lamloei/LamLoei_Board/20191214/lamloei_unofox_sfm10r4/centroid/pickplace.jpg

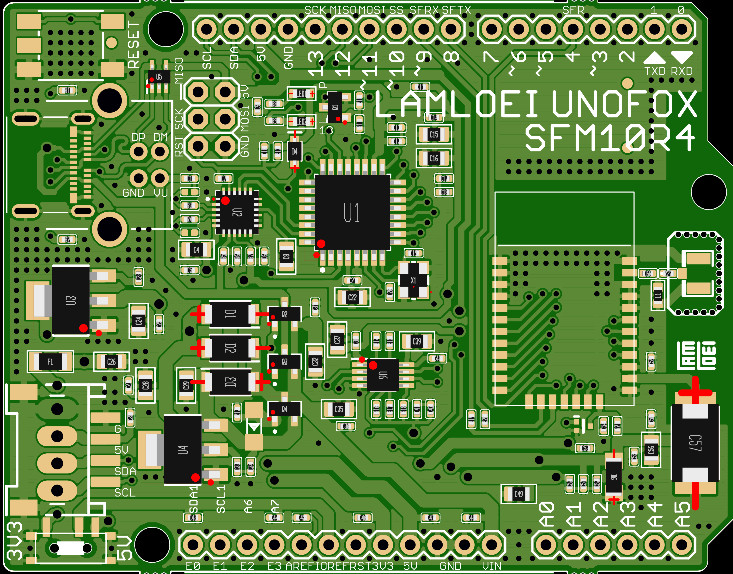
20191214/lamloei_unofox_sfm10r4/centroid/pickplace.jpg
