lamloei/LamLoei_Board/20191214/lamloei_unofox_sfm10r4/pdf/lamloei_unofox_sfm10r4.mnt.pdf

1 | ANT1 64.33 27.94 180 U.FL
2 | C1 17.46 36.83 270 100nf C0402
3 | C2 17.46 35.56 270 NC C0402
4 | C3 17.46 31.75 270 NC C0402
5 | C4 18.10 30.16 90 4.7uf C0805
6 | C5 17.46 28.26 90 100nf C0402
7 | C6 24.45 29.53 0 100nf C0402
8 | C7 20.64 36.83 90 100nf C0402
9 | C8 26.51 29.53 180 4.7uf C0805
10 | C9 23.81 43.50 180 100nf C0402
11 | C10 24.45 39.37 0 100nf C0402
12 | C11 39.05 45.40 90 100nf C0402
13 | C12 36.83 41.59 270 100nf C0402
14 | C13 36.83 40.32 270 100nf C0402
15 | C14 40.32 42.55 90 100nf C0402
16 | C15 40.32 40.96 90 4.7uf C0805
17 | C16 40.32 38.73 90 4.7uf C0805
18 | C17 41.27 36.83 90 100nf C0402
19 | C18 41.27 35.56 90 100nf C0402
20 | C19 38.42 29.85 270 10pf C0402
21 | C20 36.20 26.19 180 10pf C0402
22 | C21 32.70 27.30 270 100nf C0402
23 | C22 32.70 25.72 270 4.7uf C0805
24 | C23 12.70 27.62 0 100nf C0402
25 | C24 12.70 23.50 180 4.7uf C0805
26 | C25 14.61 23.18 180 100nf C0402
27 | C26 10.16 19.69 270 4.7uf C0805
28 | C27 11.75 17.46 0 100nf C0402
29 | C28 13.34 17.46 0 4.7uf C0805
30 | C29 17.14 17.46 180 4.7uf C0805
31 | C30 11.91 14.45 0 100nf C0402
32 | C31 29.21 24.77 0 100nf C0402
33 | C32 29.21 19.69 180 4.7uf C0805
34 | C33 21.91 9.84 180 100nf C0402
35 | C34 23.18 9.84 180 100nf C0402
36 | C35 31.43 15.24 270 4.7uf C0805
37 | C36 32.07 13.65 270 100nf C0402
38 | C37 31.27 21.75 0 4.7uf C0805
39 | C38 33.02 21.59 0 100nf C0402
40 | C39 38.73 21.59 270 4.7uf C0805
41 | C40 40.64 20.00 270 100nf C0402
42 | C41 38.73 15.24 0 100nf C0402
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
112 | ZFC2 58.42 45.72 0 FIDUCIAL1X2 FIDUCIAL-1X2
113 | ZFC3 58.42 39.69 0 FIDUCIAL1X2 FIDUCIAL-1X2
114 | ZFD1 69.85 68.58 0 FIDUCIAL1X2 FIDUCIAL-1X2
115 | ZFD2 -1.27 -15.24 0 FIDUCIAL1X2 FIDUCIAL-1X2
116 | ZFD3 69.85 -15.24 0 FIDUCIAL1X2 FIDUCIAL-1X2
117
