lamloei/LamLoei_Board/20191212/lamloei_umo32c_r2_1/pcb/3c29d403bb60a0421abf6645f51ca68c.png

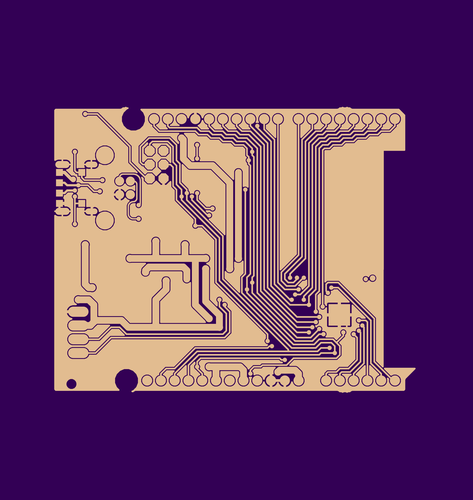
20191212/lamloei_umo32c_r2_1/pcb/3c29d403bb60a0421abf6645f51ca68c.png
