lamloei/LamLoei_Board/20191212/lamloei_umo32c_r2_1/pcb/5b07fe66cb3bcef6738aa973fb65b398.png

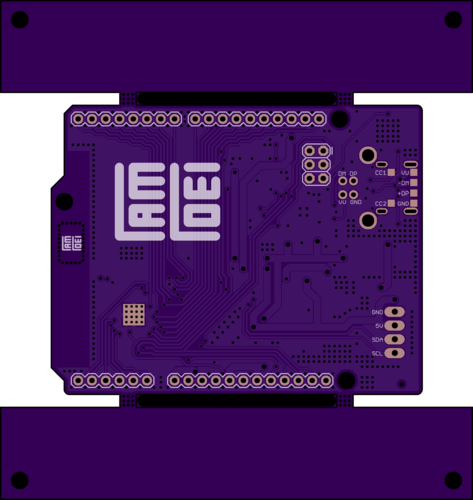
20191212/lamloei_umo32c_r2_1/pcb/5b07fe66cb3bcef6738aa973fb65b398.png
