lamloei/LamLoei_Board/20191212/lamloei_umo32c_r2_1/pcb/7d4cf361d7756bc5d7ffdf4a4ff68cea.png

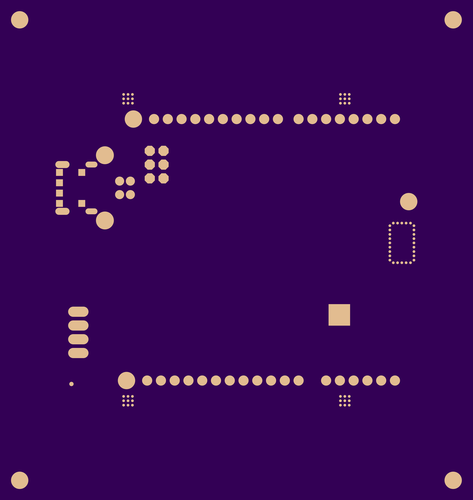
20191212/lamloei_umo32c_r2_1/pcb/7d4cf361d7756bc5d7ffdf4a4ff68cea.png
