lamloei/LamLoei_Board/20191212/lamloei_umo32c_r2_1/pcb/9e315bc2b7d5afac4a2b9fdc106094de.png

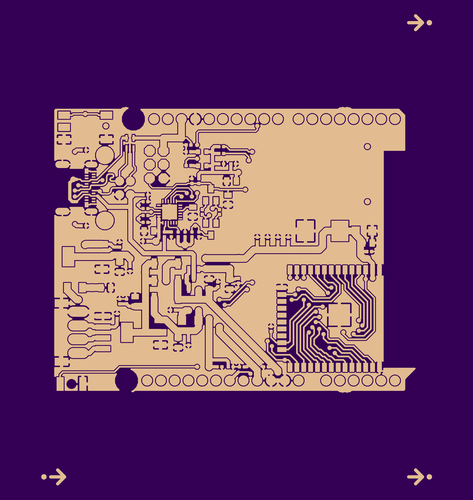
20191212/lamloei_umo32c_r2_1/pcb/9e315bc2b7d5afac4a2b9fdc106094de.png
