lamloei/LamLoei_Board/20191212/lamloei_umo32c_r2_1/pcb/21e5464734f9943f81f2c8abdc33844c.png

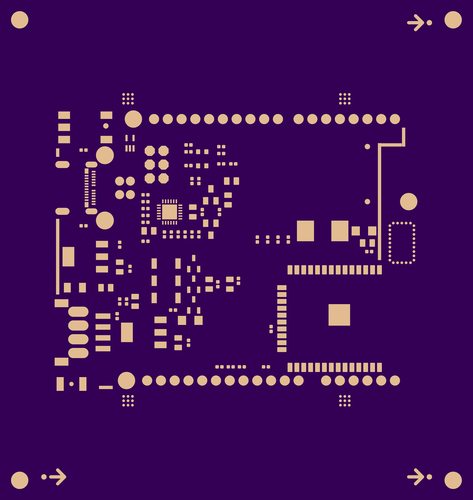
20191212/lamloei_umo32c_r2_1/pcb/21e5464734f9943f81f2c8abdc33844c.png
