lamloei/LamLoei_Board/20191212/lamloei_umo32c_r2_1/pcb/46ba95ce201f5ac81815250e2ac2148b.png

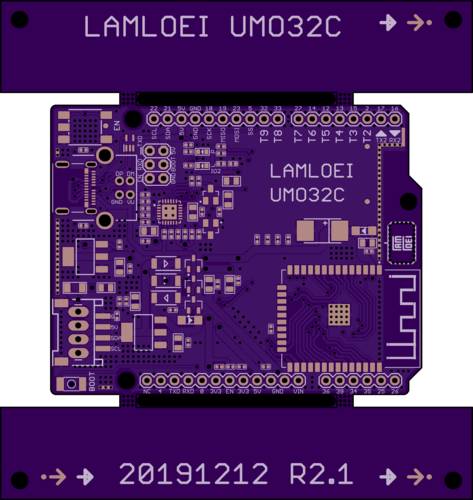
20191212/lamloei_umo32c_r2_1/pcb/46ba95ce201f5ac81815250e2ac2148b.png
