lamloei/LamLoei_Board/20191212/lamloei_umo32c_r2_1/pcb/0055d96e3a28c76eef77bcb2c69d87cb.png

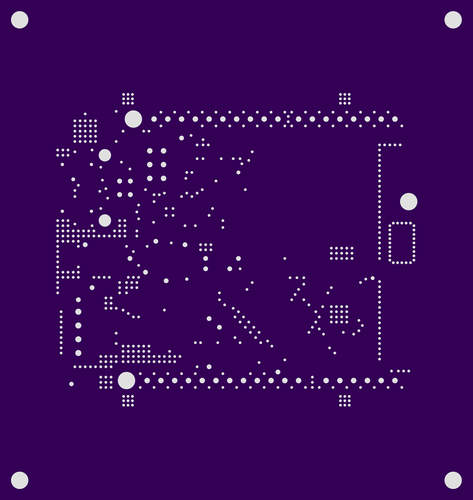
20191212/lamloei_umo32c_r2_1/pcb/0055d96e3a28c76eef77bcb2c69d87cb.png
