lamloei/LamLoei_Board/20191212/lamloei_umo32c_r2_1/pcb/290d0b5f936ab9caede79cce423379fe.png

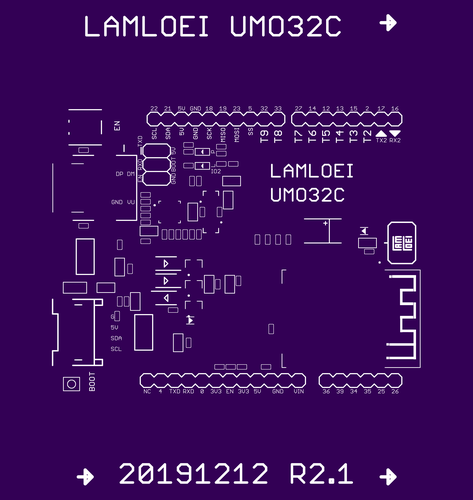
20191212/lamloei_umo32c_r2_1/pcb/290d0b5f936ab9caede79cce423379fe.png
