lamloei/LamLoei_Board/20191212/lamloei_umo32c_r2_1/pcb/a6f73144b6bf3f7a0db687b48dd24005.png

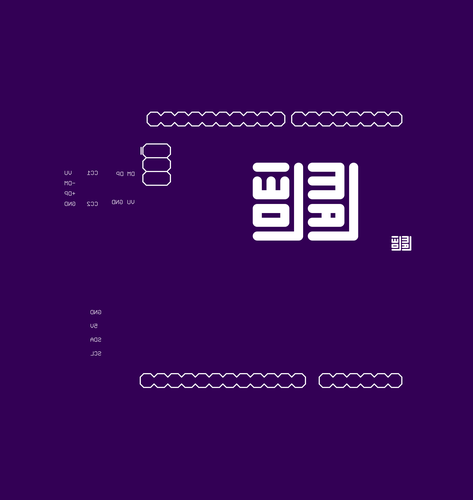
20191212/lamloei_umo32c_r2_1/pcb/a6f73144b6bf3f7a0db687b48dd24005.png
