lamloei/LamLoei_Board/20191212/lamloei_umo32c_r2_1/pcb/bb0776c8c3ad607a0b8c97d8b6b9e12e.png

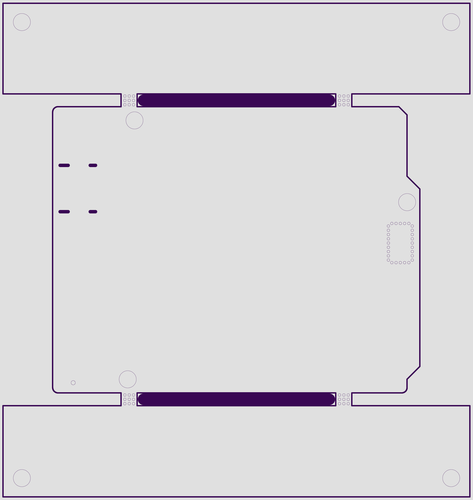
20191212/lamloei_umo32c_r2_1/pcb/bb0776c8c3ad607a0b8c97d8b6b9e12e.png
