lamloei/LamLoei_Board/20191214/lamloei_unofox_sfm10r4/centroid/patch.png

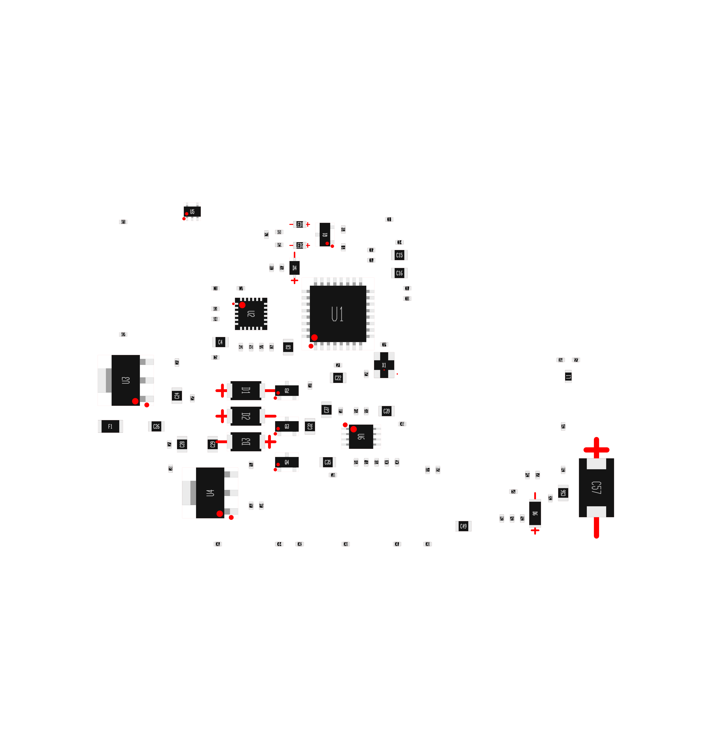
20191214/lamloei_unofox_sfm10r4/centroid/patch.png
