lamloei/LamLoei_Board/20191214/lamloei_unofox_sfm10r4/pcb/03cc458a7130fd2770615693fb23bed4.png

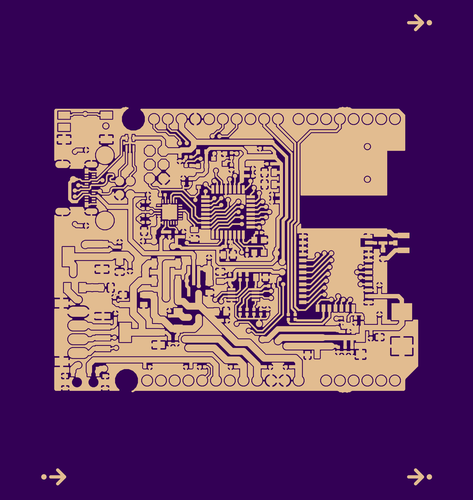
20191214/lamloei_unofox_sfm10r4/pcb/03cc458a7130fd2770615693fb23bed4.png
