lamloei/LamLoei_Board/20191214/lamloei_unofox_sfm10r4/pcb/69f6032c377717e37dd68168a04f74e7.png

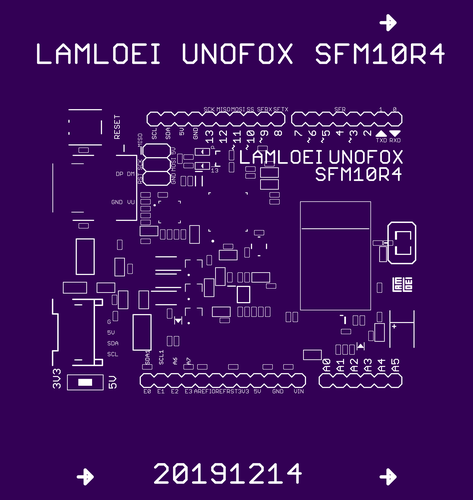
20191214/lamloei_unofox_sfm10r4/pcb/69f6032c377717e37dd68168a04f74e7.png
