lamloei/LamLoei_Board/20191214/lamloei_unofox_sfm10r4/pcb/173a8f5d769e4a11c15a2a0c7e9a4812.png

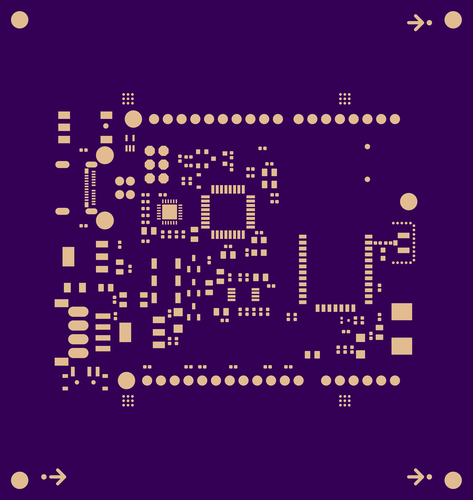
20191214/lamloei_unofox_sfm10r4/pcb/173a8f5d769e4a11c15a2a0c7e9a4812.png
