lamloei/LamLoei_Board/20191214/lamloei_unofox_sfm10r4/pcb/0261daf86479519b221c0637769d68ae.png

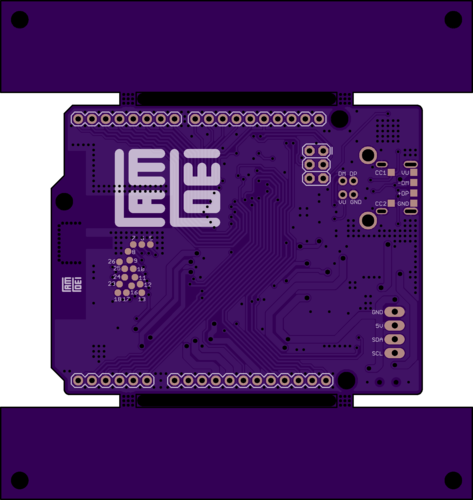
20191214/lamloei_unofox_sfm10r4/pcb/0261daf86479519b221c0637769d68ae.png
