lamloei/LamLoei_Board/20191214/lamloei_unofox_sfm10r4/pcb/3473c46d8aa6374c92cb49689961052b.png

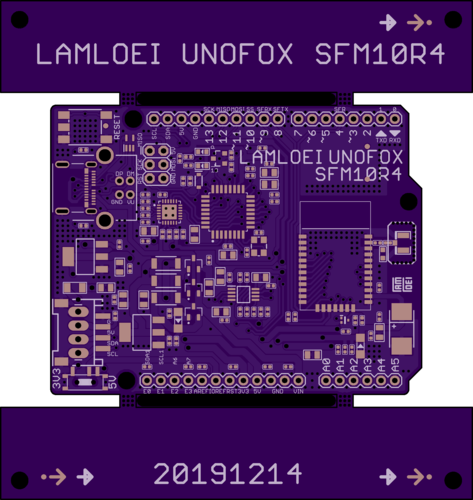
20191214/lamloei_unofox_sfm10r4/pcb/3473c46d8aa6374c92cb49689961052b.png
