lamloei/LamLoei_Board/20191214/lamloei_unofox_sfm10r4/pcb/82975a9f8b1be8654ebc2334c8a1735c.png

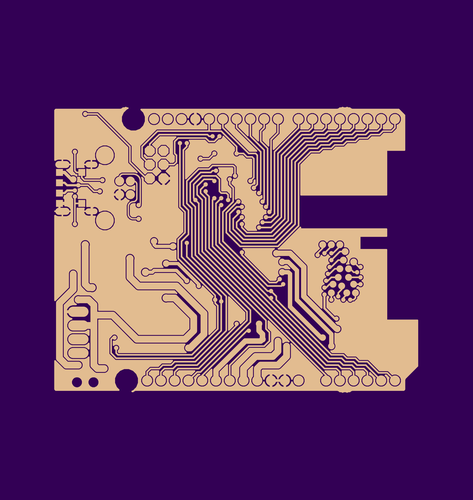
20191214/lamloei_unofox_sfm10r4/pcb/82975a9f8b1be8654ebc2334c8a1735c.png
