lamloei/LamLoei_Board/20191214/lamloei_unofox_sfm10r4/pcb/717796f1c0769e52ed0cd9b32c980103.png

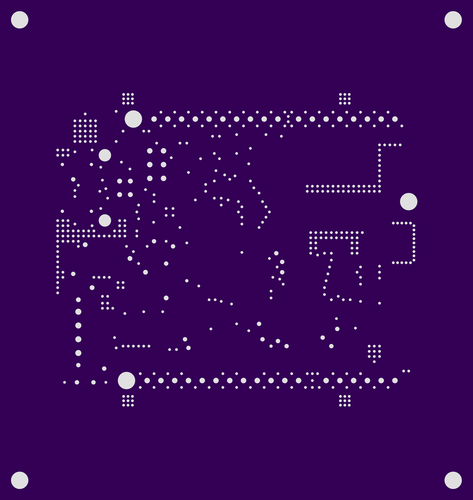
20191214/lamloei_unofox_sfm10r4/pcb/717796f1c0769e52ed0cd9b32c980103.png
