lamloei/LamLoei_Board/20191212/lamloei_umo32c_r2_1/pdf/lamloei_umo32cc_r2_1_BOM1.pdf

Comment | Designator | Footprint | LCSC Part #（optional）
CL05B104KO5NNNC - 100NF 16V 0402 | C1, C5, C6, C7, C9, C10, C11, C12, C15, C17, C19, C20, C22, C24, C26, C28, C29, C30, C31, C32, C33, C36, C37, C38, C39 | 0402_C | C1525
CL21A475KAQNNNE - 4.7UF 25V 0805 | C4, C8, C13, C14, C16, C18, C21, C23, C25, C27, C34 | 0805_C | C1779
EXTEND - 6TPE470MAZU | C35 | CASE-D_7343 | C79114
EXTEND - PMEG3050EP,115 | D1, D2, D3 | SOD-128 | C50603
EXTEND - ZMM12 | D4 | LL-34 | C7172
EXTEND - ZMM3V6 | D5 | LL-34 | C8057
EXTEND - MF-NSMF050-2 | F1 | 1206_F | C75464
19-217/BHC-ZL1M2RY/3T | LED1 | 0603_L | C72041
19-213/Y2C-CQ2R2L/3T(CY) | LED2 | 0603_L | C72038
S8050 | Q1, Q2 | SOT-23-3 | C2146
EXTEND - DMG2305UX-7 | Q3, Q4, Q5 | SOT-23-3 | C150470
0402WGF5101TCE - 5.1K 0402 | R1, R2 | 0402_R | C25905
0402WGF0000TCE - 0 0402 | R3, R4 | 0402_R | C17168
0402WGF2402TCE - 24K 0402 | R5 | 0402_R | C25769
0402WGF4702TCE - 47K 0402 | R6 | 0402_R | C25792
0402WGF1202TCE - 12K 0402 | R7, R8, R9, R10, R15, R16 | 0402_R | C25752
0402WGF2201TCE - 2.2K 0402 | R11, R12 | 0402_R | C25879
0402WGF1003TCE - 100K 0402 | R13, R14, R17 | 0402_R | C25741
CP2104-F03-GMR | U2 | QFN-24_EP_4.0x4.0x0.5P | C47742
EXTEND - LM1117MPX-3.3/NOPB | U3 | SOT-223 | C9662
EXTEND - LM1117MPX-5.0/NOPB | U4 | SOT-223 | C9663
EXTEND - ESDA6V1W5-5/TR | U5 | SOT-353 | C167129
