lamloei/LamLoei_Board/20191214/lamloei_unofox_sfm10r4/bom/lamloei_unofox_sfm10r4_BOM1.xlsx

Comment | Designator | Footprint | LCSC Part #（optional）
CL05B104KO5NNNC - 100NF 16V 0402 | C1, C5, C6, C7, C9, C10, C11, C12, C13, C14, C17, C18, C21, C23, C25, C27, C30, C31, C33, C34, C36, C38, C40, C41, C42, C43, C44, C45, C46, C47, C48, C50, C51, C52, C53, C54, C55, C58, C59 | 0402_C | C1525
CL21A475KAQNNNE - 4.7UF 25V 0805 | C4, C8, C15, C16, C22, C24, C26, C28, C29, C32, C35, C37, C39, C49, C56 | 0805_C | C1779
CL05C100JB5NNNC - 10PF 50V 0402 | C19, C20 | 0402_C | C32949
EXTEND - 6TPE470MAZU | C57 | CASE-D_7343 | C79114
0402CG101J500NT - 100PF 50V 0402 | C60 | 0402_C | C1546
EXTEND - PMEG3050EP,115 | D1, D2, D3 | SOD-128 | C50603
1N4148WS - SWITCHING DIODE 100V 150MA | D4 | SOD-323F | C2128
EXTEND - ZMM3V6 | D6 | LL-34 | C8057
EXTEND - MF-NSMF050-2 | F1 | 1206_F | C75464
SDCL1608C47NJTDF - 47NH ±5% 300MA 0603 | L1 | 0603_L | C29683
19-217/BHC-ZL1M2RY/3T | LED1 | 0603_L | C72041
19-213/Y2C-CQ2R2L/3T(CY) | LED2 | 0603_L | C72038
2N7002 - MOSFET N TRENCH 60V 115MA | Q1 | SOT-23-3 | C8545
EXTEND - DMG2305UX-7 | Q2, Q3, Q4 | SOT-23-3 | C150470
0402WGF5101TCE - 5.1K 0402 | R1, R2 | 0402_R | C25905
0402WGF0000TCE - 0 0402 | R3, R4, R19, R20, R22 | 0402_R | C17168
0402WGF2402TCE - 24K 0402 | R5 | 0402_R | C25769
0402WGF4702TCE - 47K 0402 | R6 | 0402_R | C25792
0402WGF1202TCE - 12K 0402 | R7, R12, R21 | 0402_R | C25752
0402WGF2201TCE - 2.2K 0402 | R8, R9, R10 | 0402_R | C25879
0402WGF1003TCE - 100K 0402 | R11, R13, R14, R15, R16, R17, R18 | 0402_R | C25741
EXTEND - ATMEGA328PB-AU | U1 | TQFP-32_7.0x7.0x0.8P | C132230
CP2104-F03-GMR | U2 | QFN-24_EP_4.0x4.0x0.5P | C47742
EXTEND - LM1117MPX-3.3/NOPB | U3 | SOT-223 | C9662
EXTEND - LM1117MPX-5.0/NOPB | U4 | SOT-223 | C9663
EXTEND - ESDA6V1W5-5/TR | U5 | SOT-353 | C167129
EXTEND - PCA9517ADP,118 | U6 | TSSOP-8_3.0x3.0x0.65P | C80799
X322516MLB4SI - SMD CRYSTAL RESONATORS 16MHZ | X1 | SMD-3225_4P | C13738
