lamloei/LamLoei_Board/20191214/lamloei_unofox_sfm10r4/pdf/lamloei_unofox_sfm10r4.sch.pdf

# GNDGND ²⁴K 47K

# GNDGNDGND VCC VCC

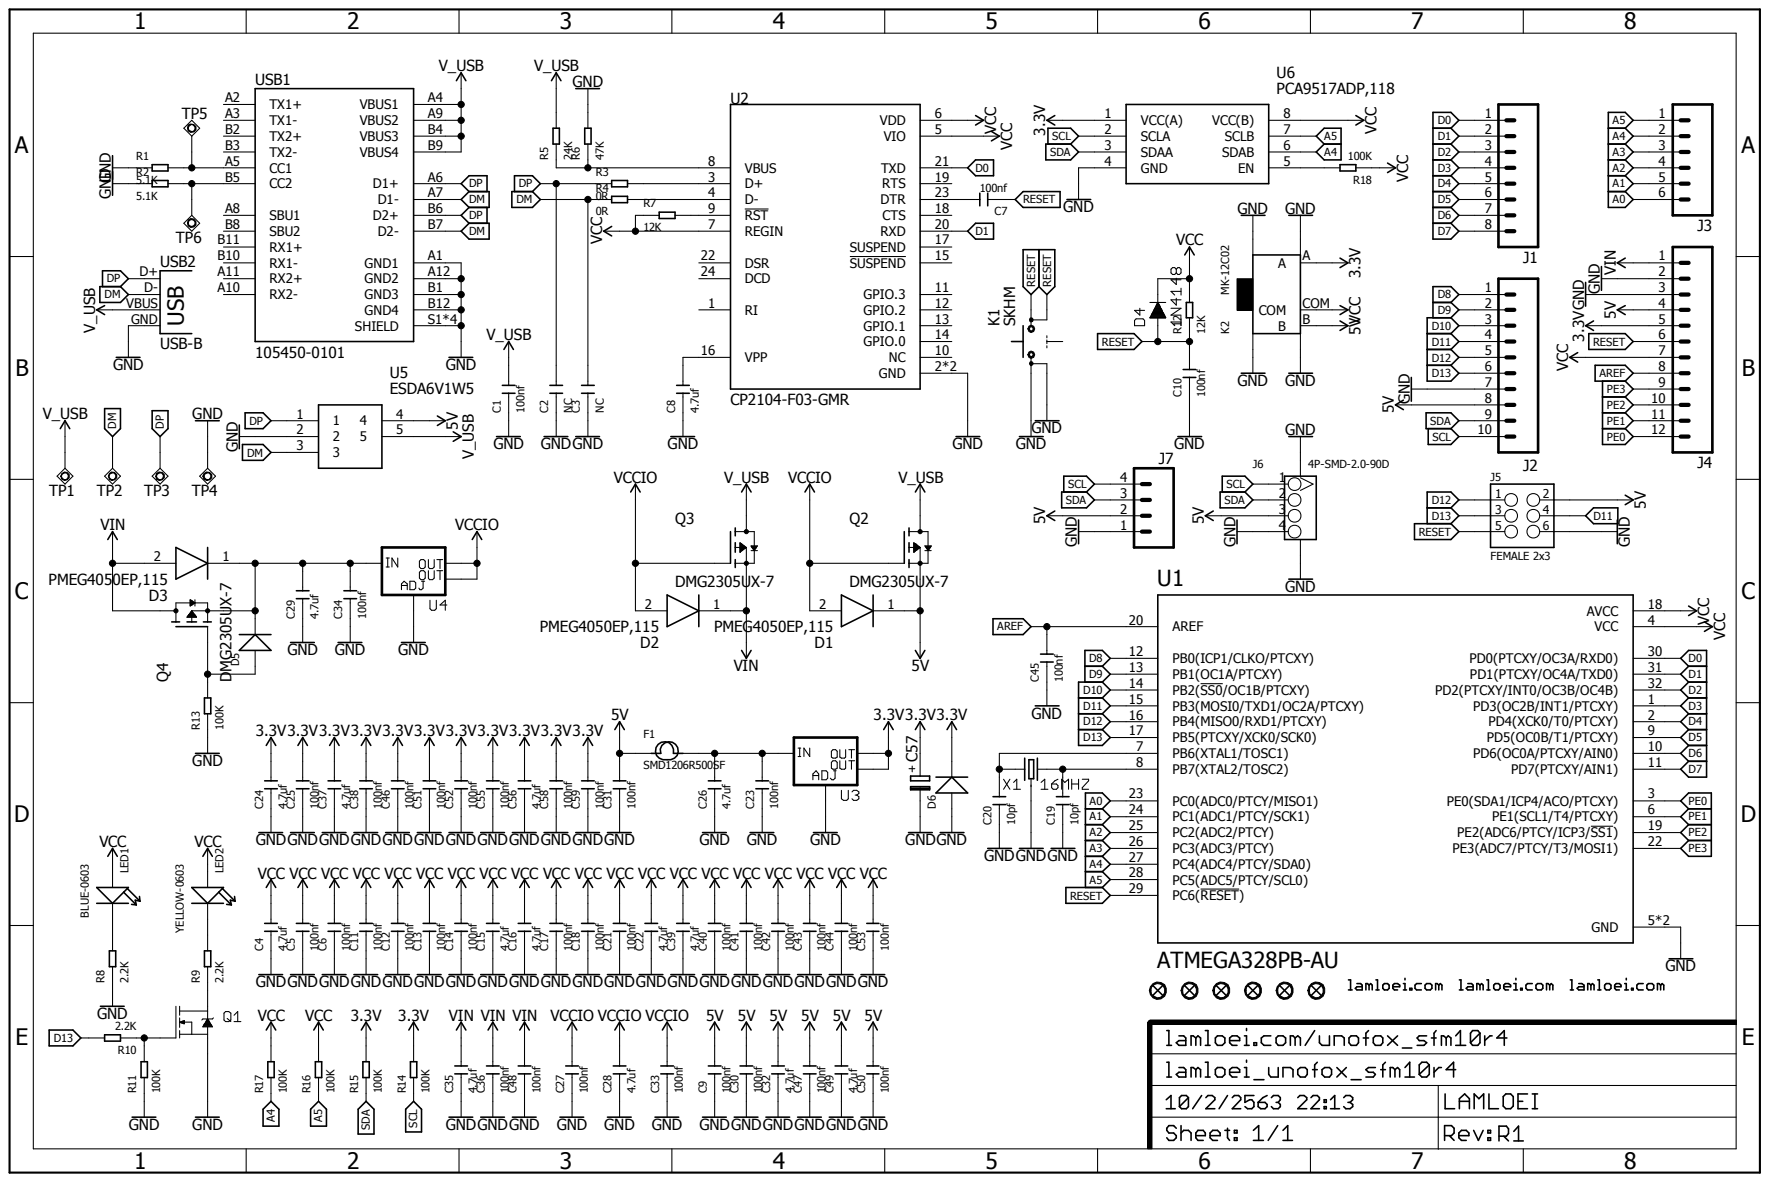
[picture p20: page 1]

1

2

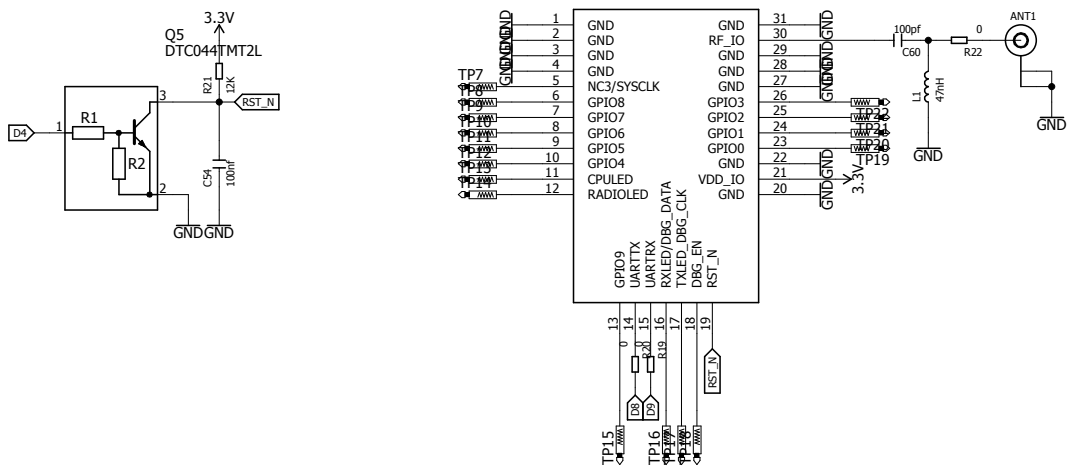
[picture p21: page 2]

GND GND

GND GND GND
