lamloei/LamLoei_Board/20191212/lamloei_umo32c_r2_1/pdf/lamloei_umo32c_r2_1.sch.pdf

# GNDGND ²⁴K 47K

A

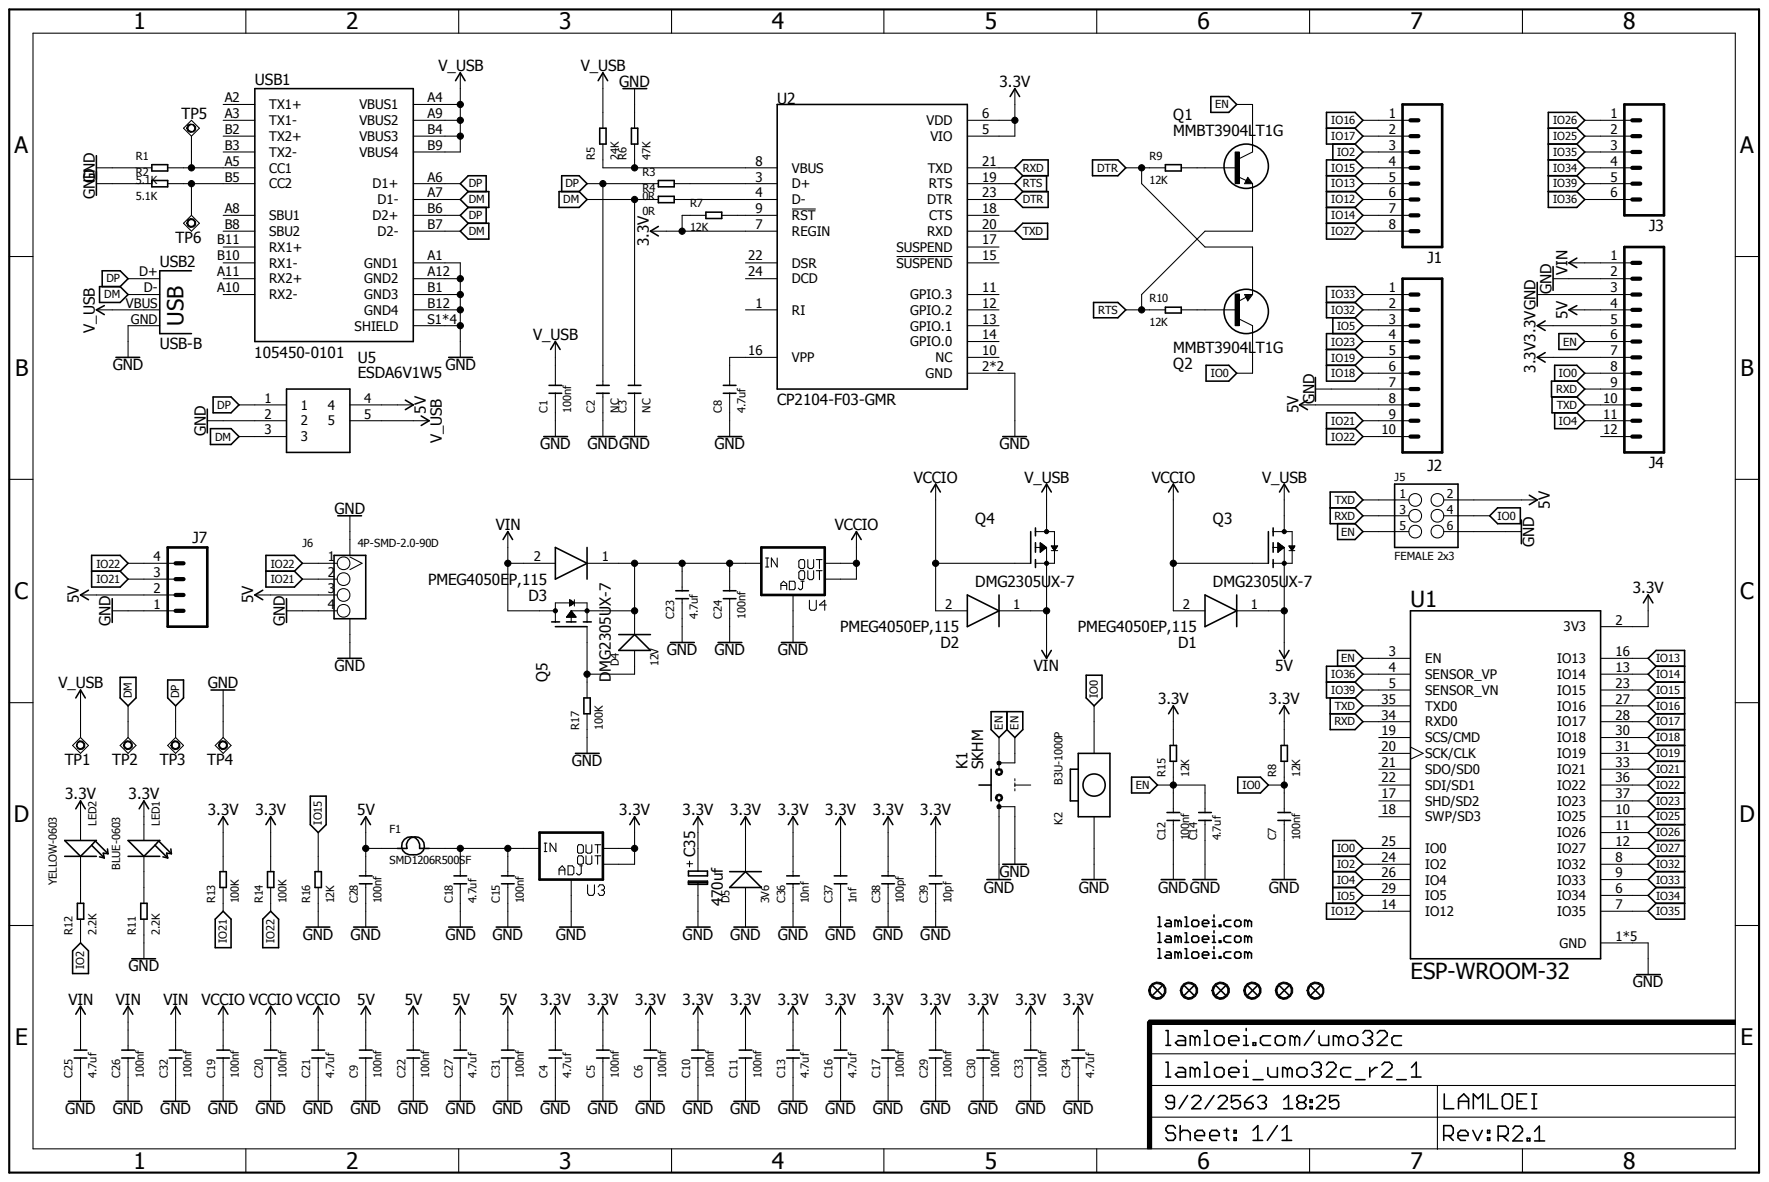
[picture p22: page 1]

GND GND
