lamloei/LamLoei_Board/20191214/lamloei_unofox_sfm10r4/pdf/lamloei_unofox_sfm10r4.brd.pdf

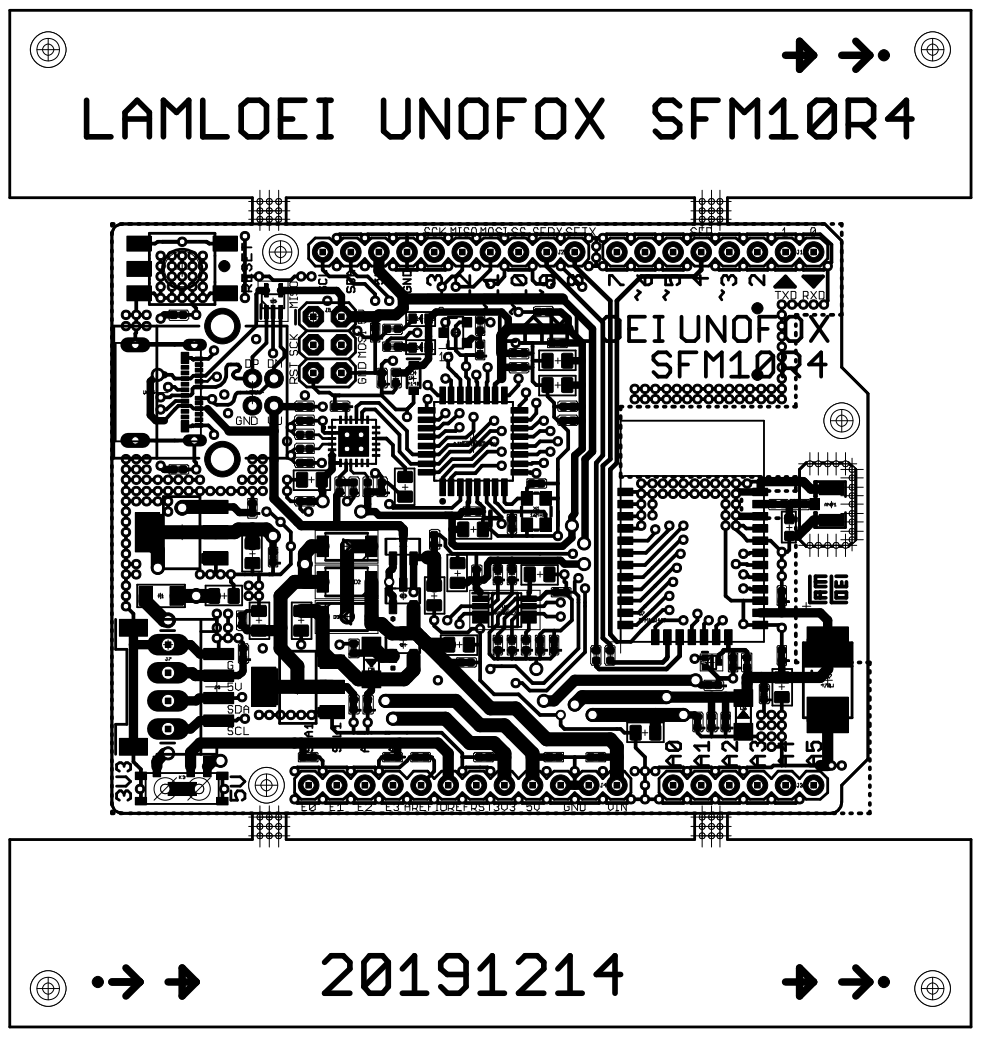
[picture p23: page 1]
