lamloei/LamLoei_Board/20191214/lamloei_unofox_sfm10r4/pdf/lamloei_unofox_sfm10r4.drawing.pdf

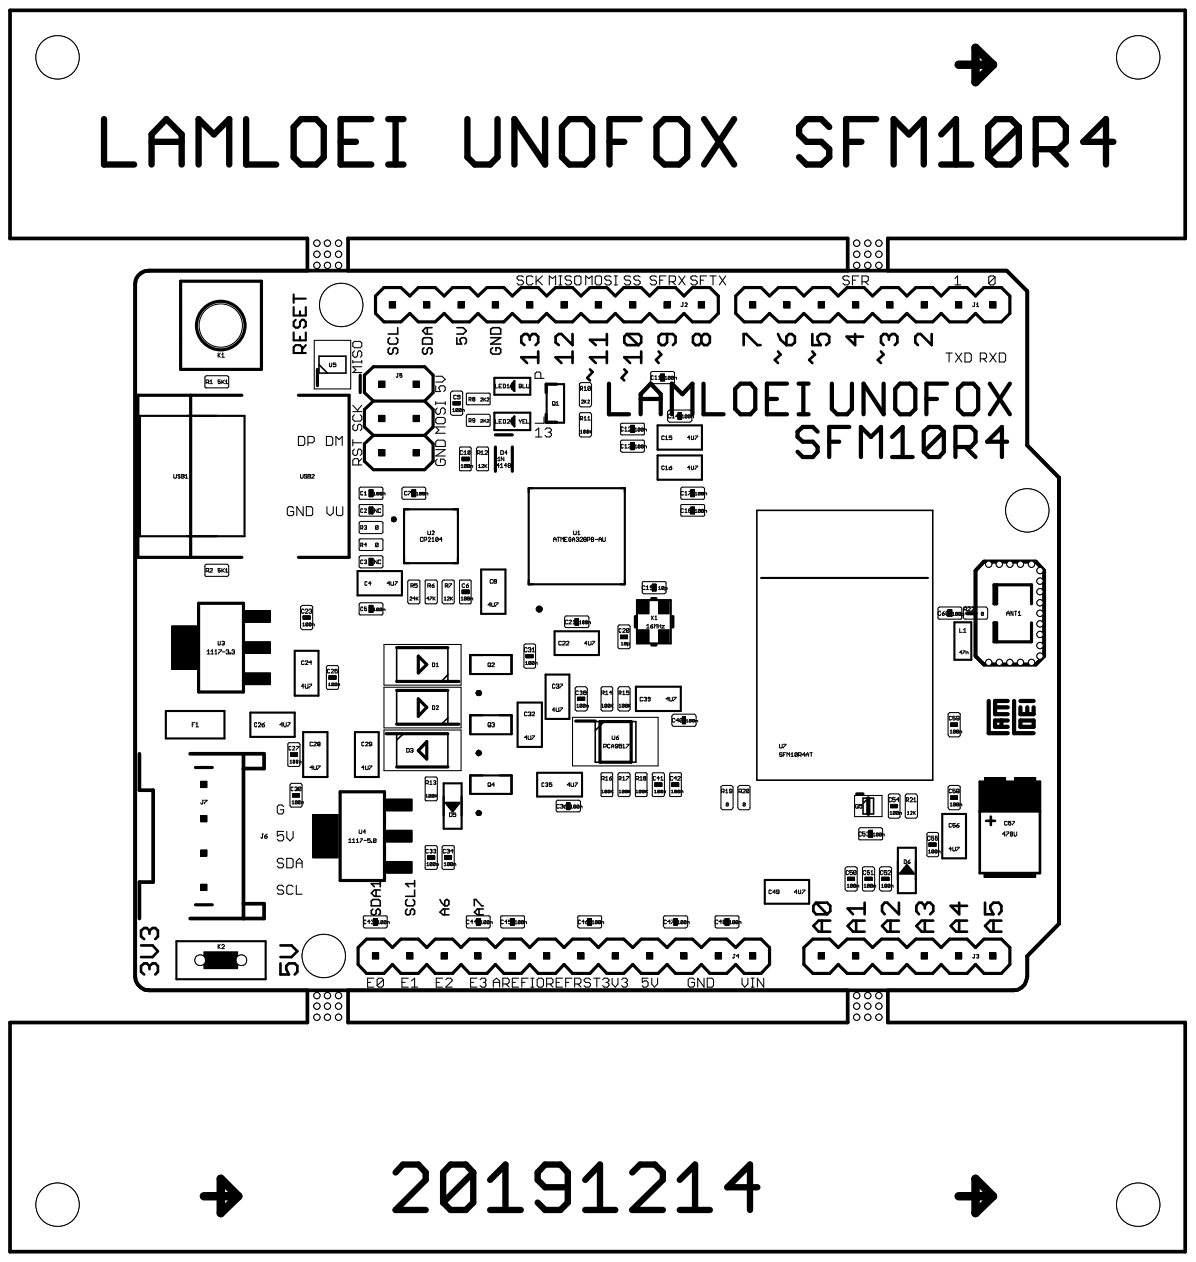
[picture p24: page 1]
