lamloei/LamLoei_Board/20191212/lamloei_umo32c_r2_1/pdf/lamloei_umo32c_r2_1.drawing.pdf

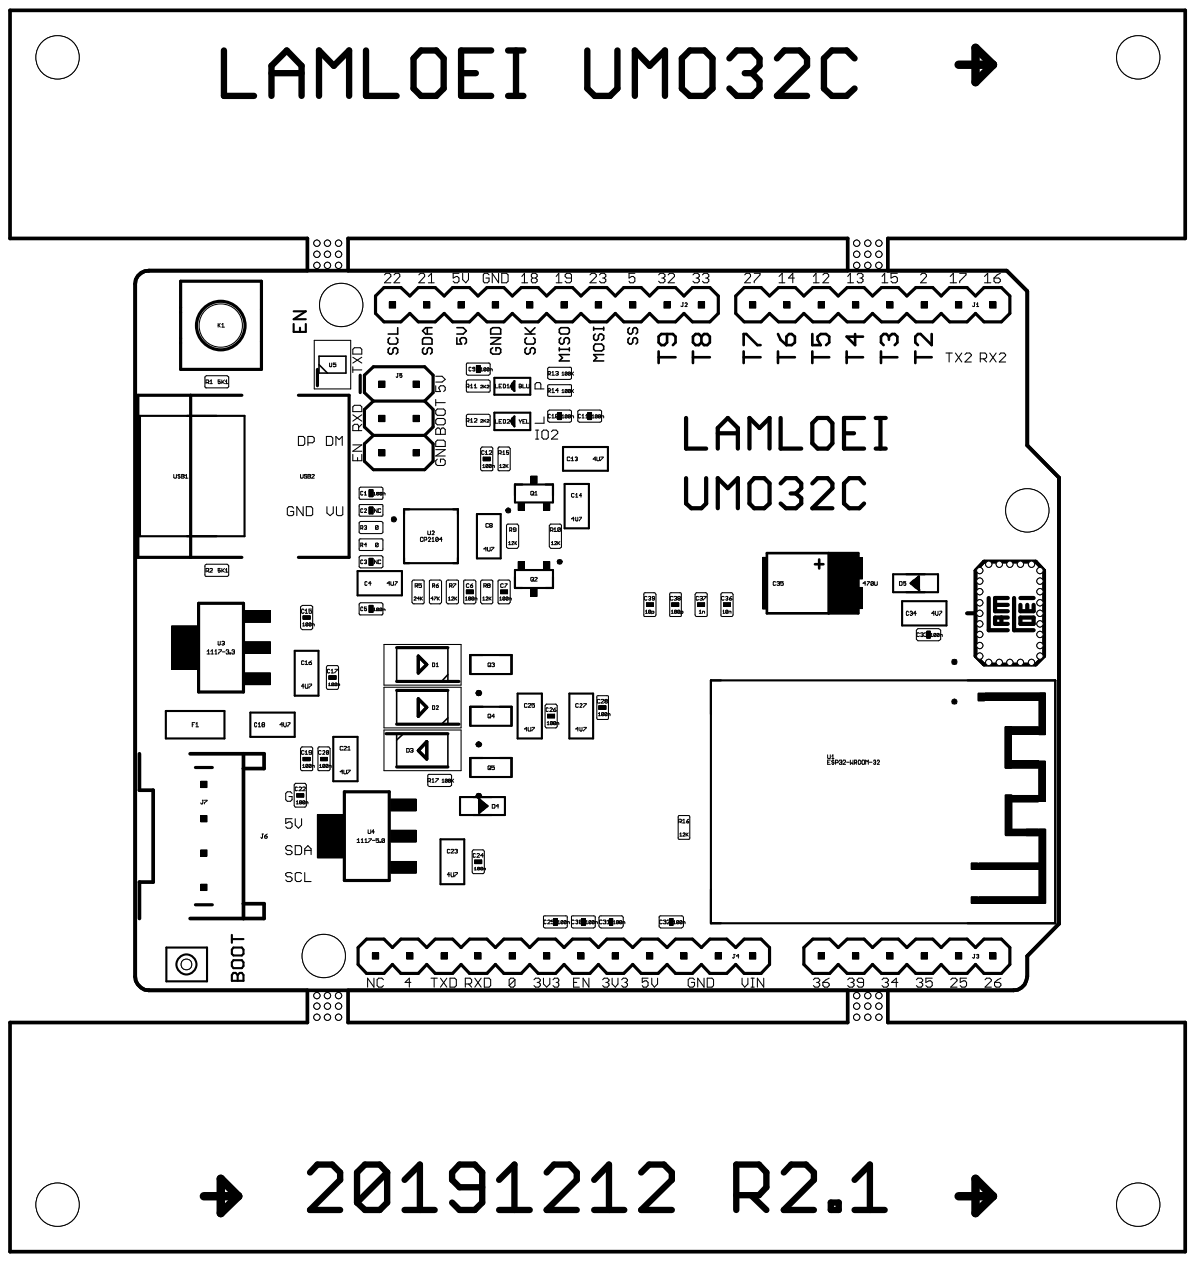
[picture p26: page 1]
