lamloei/LamLoei_Board/20191214/lamloei_unofox_sfm10r4/eagle/lamloei_unofox_sfm10r4.brd

## EAGLE design 20191214/lamloei_unofox_sfm10r4/eagle/lamloei_unofox_sfm10r4.brd (2020-02-10)

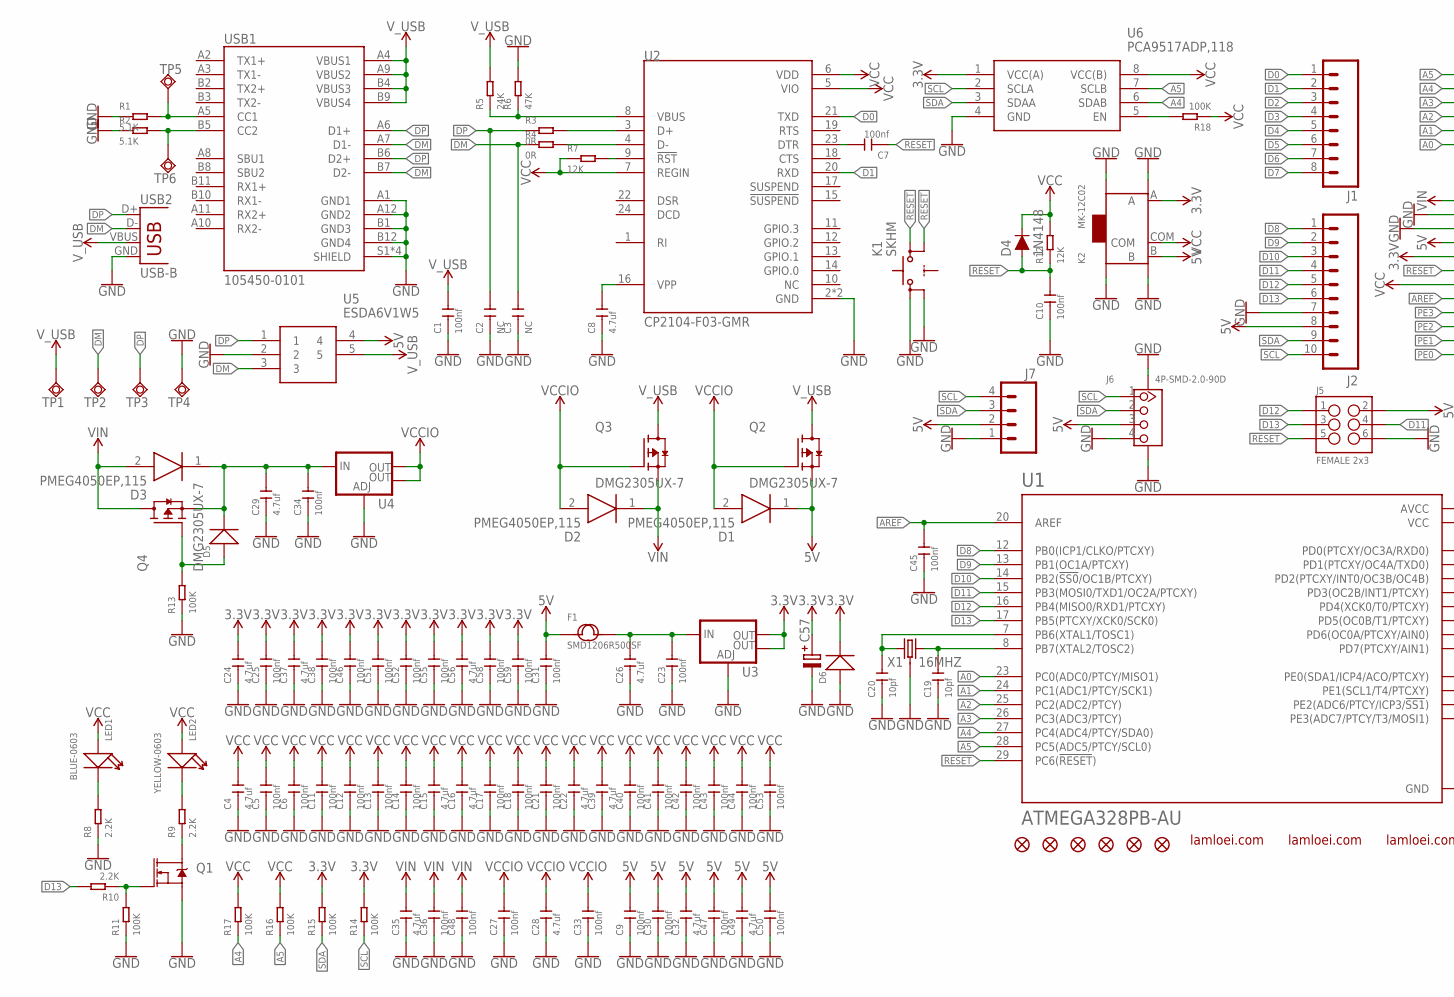
[picture p27: schematic lamloei_unofox_sfm10r4.sch, part in row 1, column 1]

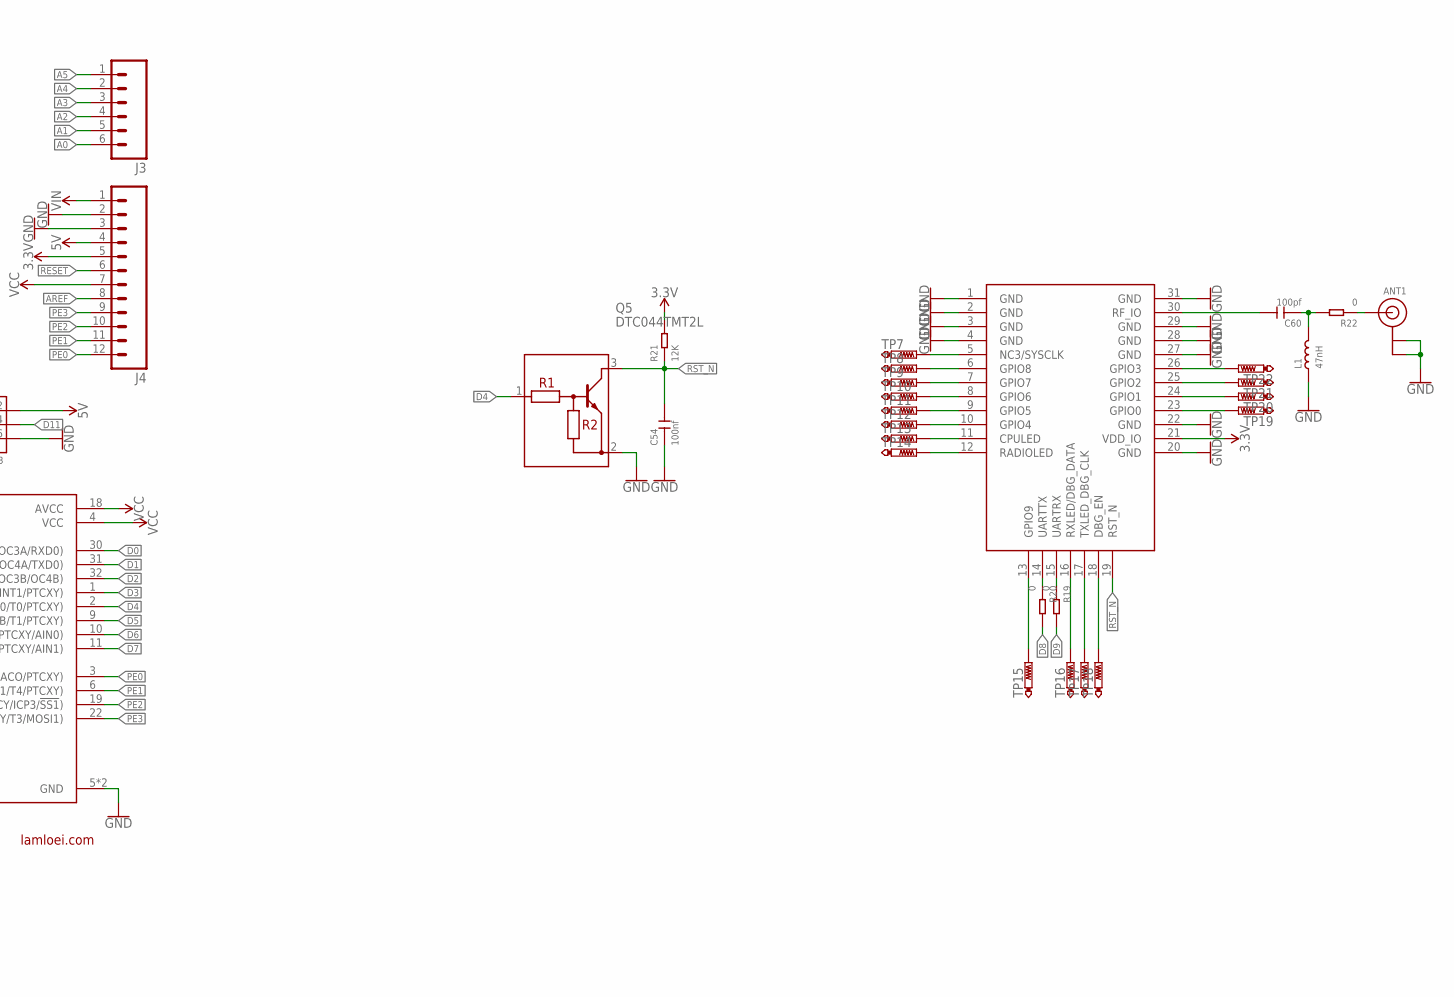
[picture p28: schematic lamloei_unofox_sfm10r4.sch, part in row 1, column 2]

Parts:
ANT1: ANTENNA_U.FL; U.FL
C1, C5, C6, C7, C9, C10, C11, C12, C13, C14, C17, C18, C21, C23, C25, C27, C30, C31, C33, C34, C36, C38, C40, C41, C42, C43, C44, C45, C46, C47, C48, C50, C51, C52, C53, C54, C55, C58, C59: 100nf; C0402
C2, C3: NC; C0402
C4, C8, C15, C16, C22, C24, C26, C28, C29, C32, C35, C37, C39, C49, C56: 4.7uf; C0805
C19, C20: 10pf; C0402
C57: C-PR-SMD-TE-D; TE-D-7343
C60: 100pf; C0402
D1, D2, D3: PMEG4050EP,115; SODFL4725X110N
D4: 1N4148; SOD-323
D5, D6: DIODE'1N4148-SMD'; LL-34
F1: SMD1206R500SF; F1206
J1: M08SILK_FEMALE_PTH; 1X08
J2: M10SILK_FEMALE_PTH; 1X10
J3: M06SILK_FEMALE_PTH; 1X06
J4: M12PTH; 1X12
J5: FEMALE 2x3; 2X3
J6: 4P-SMD-2.0-90D; HW4-SMD-2.0-90D
J7: M04LONGPADS; 1X04_LONGPADS
K1: SKHM
K2: MK-12C02; SW7-SMD-L6.7X2.7X3.2MM
L1: 47nH; L0603
LED1: BLUE-0603; LED-0603
LED2: YELLOW-0603; LED-0603
Q1: 220mA/50V/3.5Ω; SOT23-3
Q2, Q3, Q4: DMG2305UX-7; SOT91P240X110-3N_DMG2305UX-7
Q5: DTC044TMT2L; SOTFL40P120X55-3N
R1, R2: 5.1K; R0402
R3, R4: 0R; R0402
R5: 24K; R0402
R6: 47K; R0402
R7, R12, R21: 12K; R0402
R8, R9, R10: 2.2K; R0402
R11, R13, R14, R15, R16, R17, R18: 100K; R0402
R19, R20, R22: 0; R0402
TP1, TP2, TP3, TP4, TP5, TP6: TPSQTP13SQ; TP13SQ
TP7, TP8, TP9, TP10, TP11, TP12, TP13, TP14, TP15, TP16, TP17, TP18, TP19, TP20, TP21, TP22: PTR1B1,27; B1,27
U1: ATMEGA328PB-AU; QFP80P900X900X120-32N
U2: CP2104-F03-GMR
U3, U4: V_REG_LM1117SOT223; SOT223
U5: ESDA6V1W5; SOT65P210X110-5N
U6: PCA9517ADP,118; SOP65P490X110-8N
U7: WSSFM10RWSSFM10R2R4; WSSFM10R
USB1: 105450-0101
USB2: USB-B; USB-B-PTH
X1: 16MHZ; CRYSTAL-SMD-3.2X2.5MM
ZFC1, ZFC2, ZFC3: FIDUCIAL1X2; FIDUCIAL-1X2
ZFD1, ZFD2, ZFD3: FIDUCIAL1X2; FIDUCIAL-1X2
ZL1, ZL2: LAMLEOI_LOGO_3
ZL3: LAMLOEI_BIGLOGO

Connections:
3.3V: C24.2, C25.2, C37.2, C38.2, C46.2, C51.2, C52.2, C55.2, C56.2, C57.+, C58.2, C59.2, D6.C (-), J4.5, K2.A, R14.2, R15.2, R21.2, U3.2 (OUT), U3.4 (OUT), U6.1 (VCC(A)), U7.21 (VDD_IO)
5V: C9.2, C30.2, C31.2, C32.2, C47.2, C49.2, C50.2, D1.1 (K), F1.1, J2.8, J4.4, J5.2, J6.3, J7.2, K2.B, Q2.2 (S), U5.4
A0: J3.6, U1.23 (PC0(ADC0/PTCY/MISO1))
A1: J3.5, U1.24 (PC1(ADC1/PTCY/SCK1))
A2: J3.4, U1.25 (PC2(ADC2/PTCY))
A3: J3.3, U1.26 (PC3(ADC3/PTCY))
A4: J3.2, R17.1, U1.27 (PC4(ADC4/PTCY/SDA0)), U6.6 (SDAB)
A5: J3.1, R16.1, U1.28 (PC5(ADC5/PTCY/SCL0)), U6.7 (SCLB)
AREF: C45.2, J4.8, U1.20 (AREF)
D0: J1.1, U1.30 (PD0(PTCXY/OC3A/RXD0)), U2.21 (TXD)
D1: J1.2, U1.31 (PD1(PTCXY/OC4A/TXD0)), U2.20 (RXD)
D2: J1.3, U1.32 (PD2(PTCXY/INT0/OC3B/OC4B))
D3: J1.4, U1.1 (PD3(OC2B/INT1/PTCXY))
D4: J1.5, Q5.1 (B), U1.2 (PD4(XCK0/T0/PTCXY))
D5: J1.6, U1.9 (PD5(OC0B/T1/PTCXY))
D6: J1.7, U1.10 (PD6(OC0A/PTCXY/AIN0))
D7: J1.8, U1.11 (PD7(PTCXY/AIN1))
D8: J2.1, R20.2, U1.12 (PB0(ICP1/CLKO/PTCXY))
D9: J2.2, R19.2, U1.13 (PB1(OC1A/PTCXY))
D10: J2.3, U1.14 (PB2(!SS0!/OC1B/PTCXY))
D11: J2.4, J5.4, U1.15 (PB3(MOSI0/TXD1/OC2A/PTCXY))
D12: J2.5, J5.1, U1.16 (PB4(MISO0/RXD1/PTCXY))
D13: J2.6, J5.3, R10.2, U1.17 (PB5(PTCXY/XCK0/SCK0))
DM: C3.2, R4.1, TP2.TP, U5.3, USB1.A7 (D1-), USB1.B7 (D2-), USB2.D-
DP: C2.2, R3.1, TP3.TP, U5.1, USB1.A6 (D1+), USB1.B6 (D2+), USB2.D+
GND: ANT1.1 (GND), ANT1.2 (GND), C1.1, C2.1, C3.1, C4.1, C5.1, C6.1, C8.1, C9.1, C10.1, C11.1, C12.1, C13.1, C14.1, C15.1, C16.1, C17.1, C18.1, C19.1, C20.1, C21.1, C22.1, C23.1, C24.1, C25.1, C26.1, C27.1, C28.1, C29.1, C30.1, C31.1, C32.1, C33.1, C34.1, C35.1, C36.1, C37.1, C38.1, C39.1, C40.1, C41.1, C42.1, C43.1, C44.1, C45.1, C46.1, C47.1, C48.1, C49.1, C50.1, C51.1, C52.1, C53.1, C54.1, C55.1, C56.1, C57.-, C58.1, C59.1, D6.A (+), J2.7, J4.2, J4.3, J5.6, J6.4, J6.SS1, J6.SS2, J7.1, K1.1, K1.2, K2.SS1, K2.SS2, K2.SS3, K2.SS4, L1.1, Q1.2 (S), Q5.2 (E), R1.1, R2.1, R6.2, R8.1, R11.1, R13.1, TP4.TP, U1.5 (GND), U1.21 (GND), U2.2 (GND), U2.25 (GND), U3.1 (ADJ), U4.1 (ADJ), U5.2, U6.4 (GND), U7.1 (GND), U7.2 (GND), U7.3 (GND), U7.4 (GND), U7.20 (GND), U7.22 (GND), U7.27 (GND), U7.28 (GND), U7.29 (GND), U7.31 (GND), USB1.A1 (GND1), USB1.A12 (GND2), USB1.B1 (GND3), USB1.B12 (GND4), USB1.S1 (SHIELD), USB1.S2 (SHIELD), USB1.S3 (SHIELD), USB1.S4 (SHIELD), USB2.GND, X1.2 (3), X1.4 (3)
unnamed: R2.2, TP6.TP, USB1.B5 (CC2)
unnamed: R1.2, TP5.TP, USB1.A5 (CC1)
unnamed: R3.2, U2.3 (D+)
unnamed: R4.2, U2.4 (D-)
unnamed: R5.1, R6.1, U2.8 (VBUS)
unnamed: C23.2, C26.2, F1.2, U3.3 (IN)
unnamed: LED1.-, R8.2
unnamed: C20.2, U1.7 (PB6(XTAL1/TOSC1)), X1.1
unnamed: C7.2, U2.23 (DTR)
unnamed: C29.2, C34.2, D3.1 (K), D5.C (-), Q4.2 (S), U4.3 (IN)
unnamed: R7.2, U2.9 (!RST)
unnamed: LED2.-, R9.2
unnamed: C8.2, U2.16 (VPP)
unnamed: C60.2, U7.30 (RF_IO)
unnamed: C19.2, U1.8 (PB7(XTAL2/TOSC2)), X1.3 (2)
unnamed: R18.2, U6.5 (EN)
unnamed: C60.1, L1.2, R22.2
unnamed: Q1.1 (G), R10.1, R11.2
unnamed: Q1.3 (D), R9.1
unnamed: ANT1.3 (SIGNAL), R22.1
unnamed: R20.1, U7.14 (UARTTX)
unnamed: R19.1, U7.15 (UARTRX)
unnamed: D5.A (+), Q4.1 (G), R13.2
unnamed: TP7.TP, U7.5 (NC3/SYSCLK)
unnamed: TP8.TP, U7.6 (GPIO8)
unnamed: TP9.TP, U7.7 (GPIO7)
unnamed: TP10.TP, U7.8 (GPIO6)
unnamed: TP11.TP, U7.9 (GPIO5)
unnamed: TP12.TP, U7.10 (GPIO4)
unnamed: TP13.TP, U7.11 (CPULED)
unnamed: TP14.TP, U7.12 (RADIOLED)
unnamed: TP22.TP, U7.26 (GPIO3)
unnamed: TP21.TP, U7.25 (GPIO2)
unnamed: TP20.TP, U7.24 (GPIO1)
unnamed: TP19.TP, U7.23 (GPIO0)
unnamed: TP15.TP, U7.13 (GPIO9)
unnamed: TP18.TP, U7.18 (DBG_EN)
unnamed: TP17.TP, U7.17 (TXLED_DBG_CLK)
unnamed: TP16.TP, U7.16 (RXLED/DBG_DATA)
PE0: J4.12, U1.3 (PE0(SDA1/ICP4/ACO/PTCXY))
PE1: J4.11, U1.6 (PE1(SCL1/T4/PTCXY))
PE2: J4.10, U1.19 (PE2(ADC6/PTCY/ICP3/!SS1!))
PE3: J4.9, U1.22 (PE3(ADC7/PTCY/T3/MOSI1))
RESET: C7.1, C10.2, D4.A, J4.6, J5.5, K1.3 (S1), K1.4 (S2), R12.1, U1.29 (PC6(!RESET!))
RST_N: C54.2, Q5.3 (C), R21.1, U7.19 (RST_N)
SCL: J2.10, J6.1, J7.4, R14.1, U6.2 (SCLA)
SDA: J2.9, J6.2, J7.3, R15.1, U6.3 (SDAA)
VCC: C4.2, C5.2, C6.2, C11.2, C12.2, C13.2, C14.2, C15.2, C16.2, C17.2, C18.2, C21.2, C22.2, C39.2, C40.2, C41.2, C42.2, C43.2, C44.2, C53.2, D4.C, J4.7, K2.COM, LED1.+, LED2.+, R7.1, R12.2, R16.2, R17.2, R18.1, U1.4 (VCC), U1.18 (AVCC), U2.5 (VIO), U2.6 (VDD), U2.7 (REGIN), U6.8 (VCC(B))
VCCIO: C27.2, C28.2, C33.2, D1.2 (A), D2.2 (A), Q2.1 (G), Q3.1 (G), U4.2 (OUT), U4.4 (OUT)
VIN: C35.2, C36.2, C48.2, D2.1 (K), D3.2 (A), J4.1, Q3.2 (S), Q4.3 (D)
V_USB: C1.2, Q2.3 (D), Q3.3 (D), R5.2, TP1.TP, U5.5, USB1.A4 (VBUS1), USB1.A9 (VBUS2), USB1.B4 (VBUS3), USB1.B9 (VBUS4), USB2.VBUS

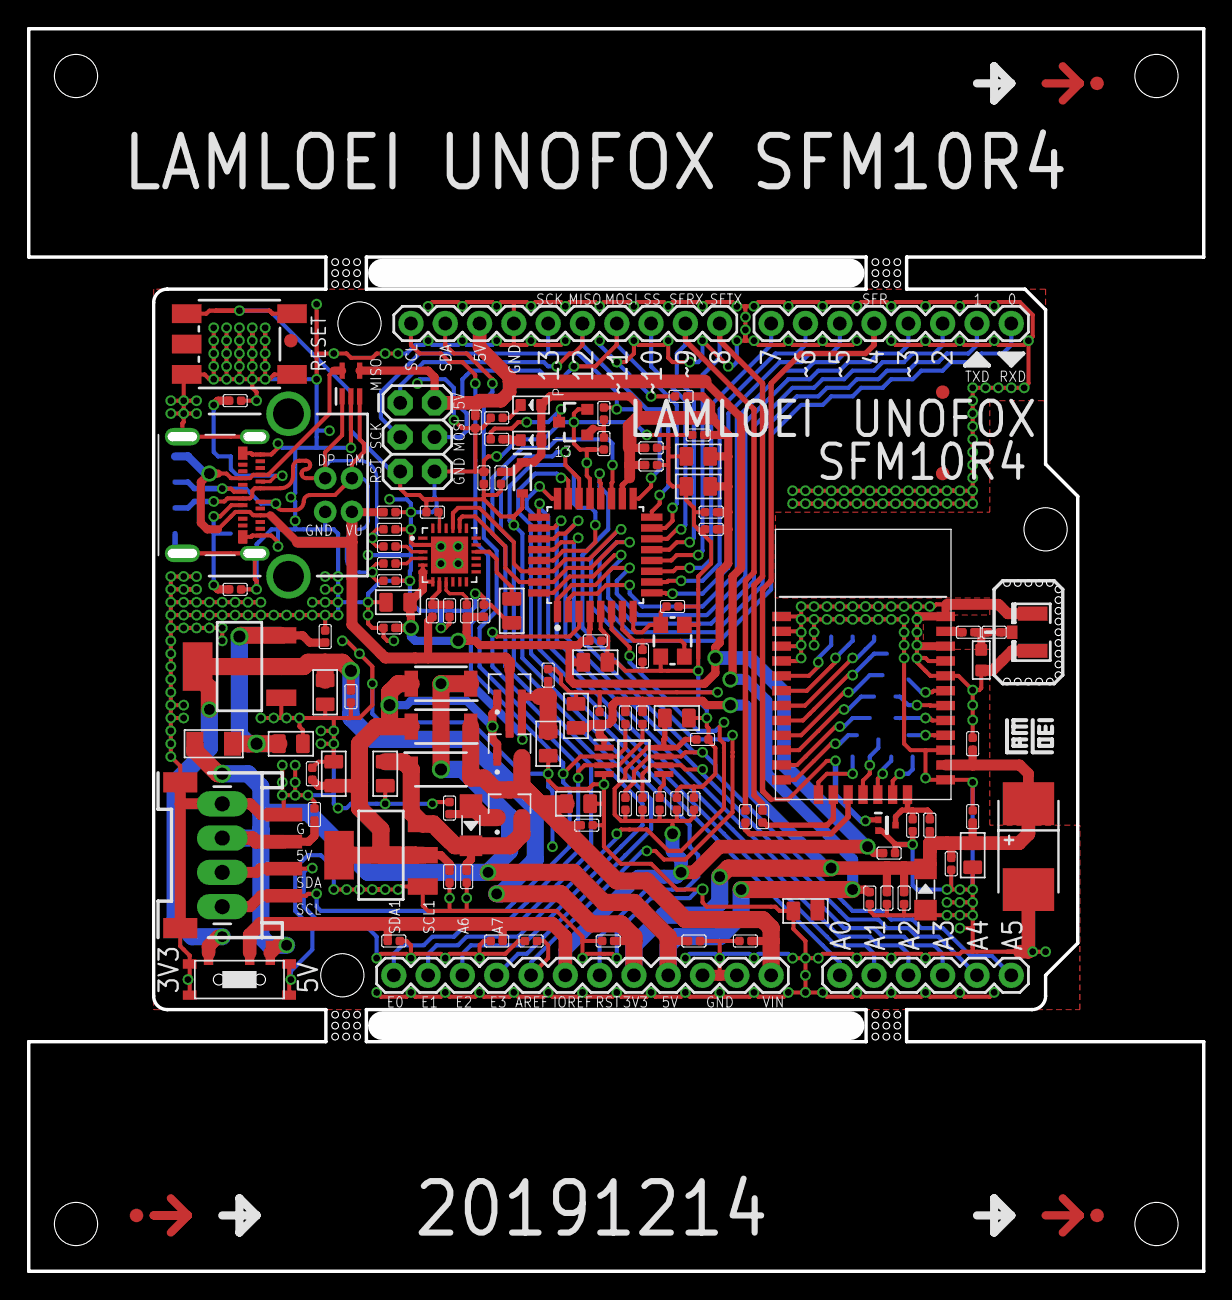
[picture p29: board lamloei_unofox_sfm10r4.brd from above]

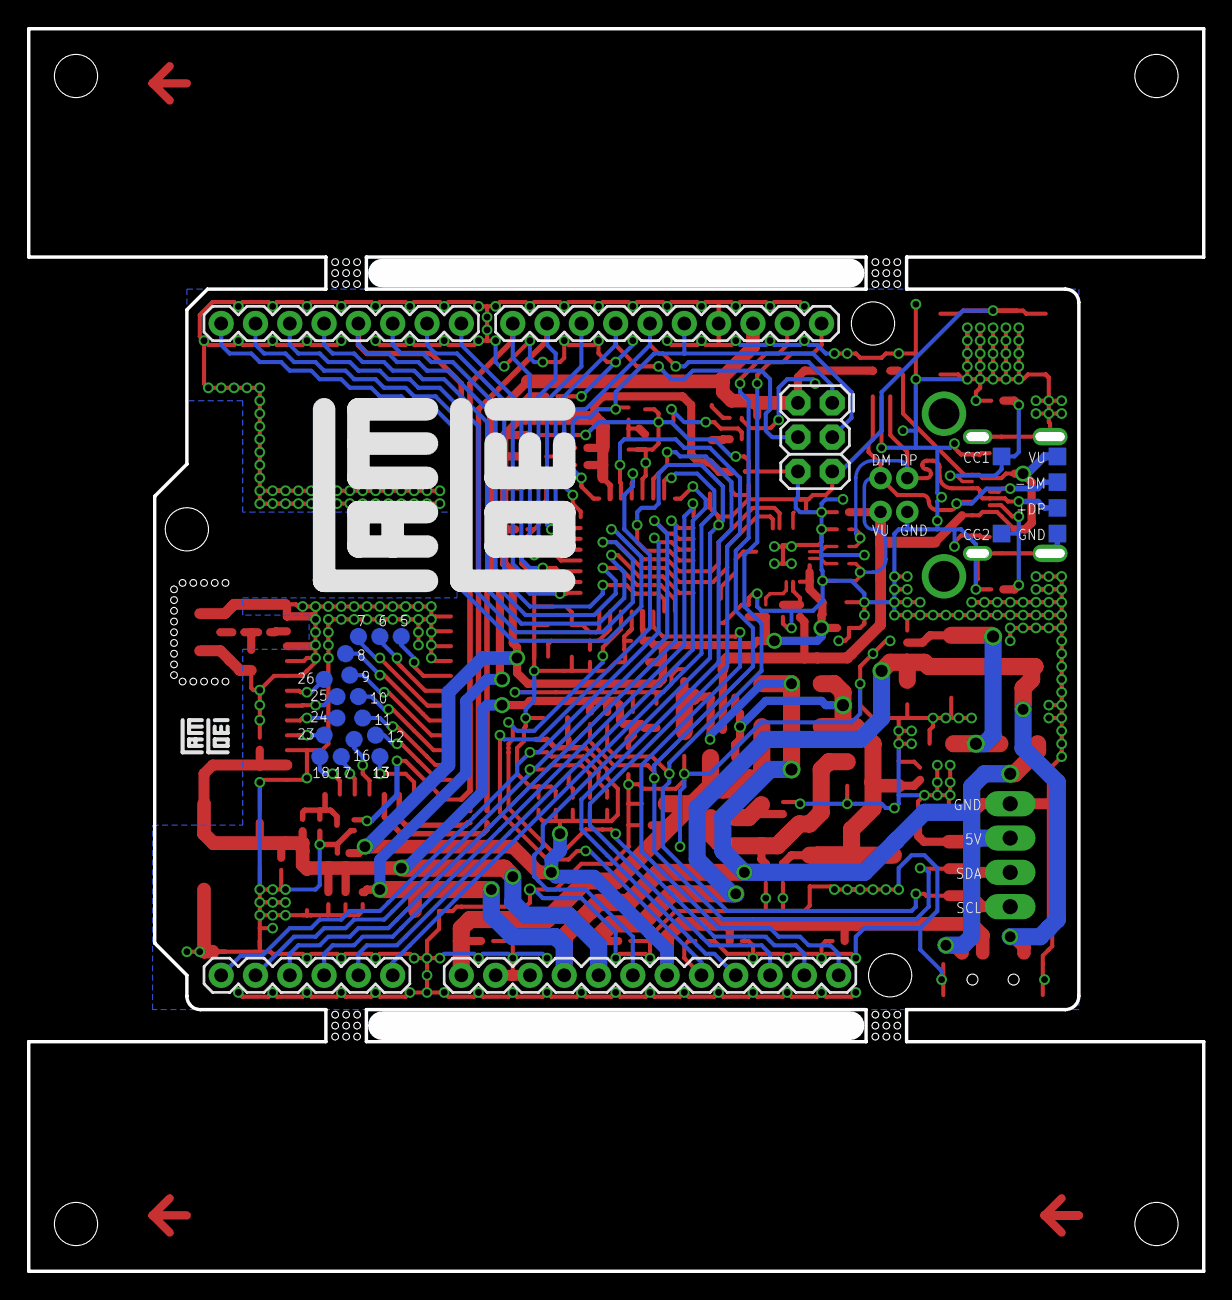
[picture p30: board lamloei_unofox_sfm10r4.brd from below]

Board: 2 copper layers, 87.0 x 92.0 mm, 148 parts (24 on the bottom side), 77 nets.
