lamloei/LamLoei_Board/20191212/lamloei_umo32c_r2_1/eagle/lamloei_umo32c_r2_1.brd

## EAGLE design 20191212/lamloei_umo32c_r2_1/eagle/lamloei_umo32c_r2_1.brd (2020-02-09)

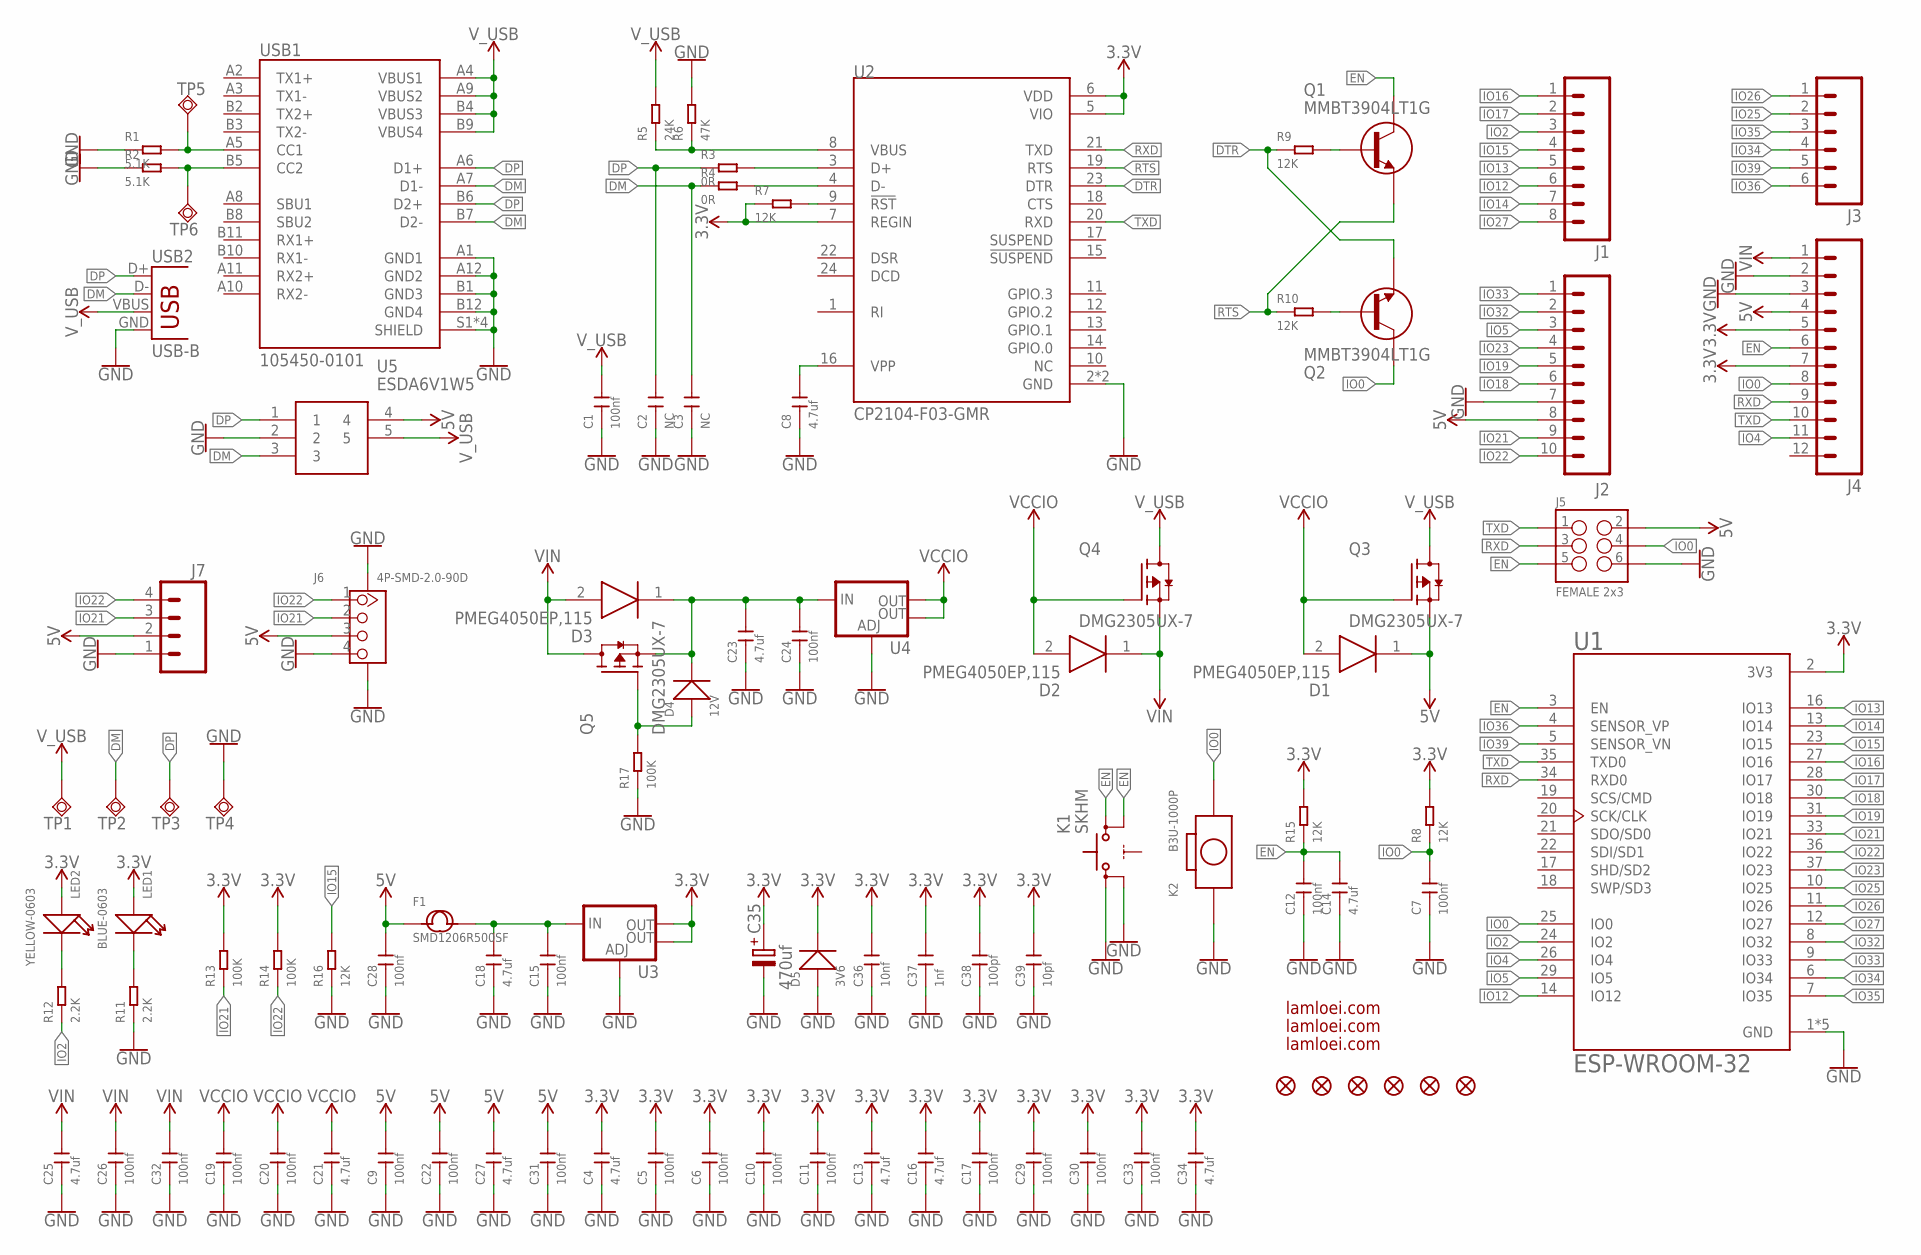
[picture p31: schematic lamloei_umo32c_r2_1.sch]

Parts:
C1, C5, C6, C7, C9, C10, C11, C12, C15, C17, C19, C20, C22, C24, C26, C28, C29, C30, C31, C32, C33: 100nf; C0402
C2, C3: NC; C0402
C4, C8, C13, C14, C16, C18, C21, C23, C25, C27, C34: 4.7uf; C0805
C35: 470uf; TE-D-7343
C36: 10nf; C0402
C37: 1nf; C0402
C38: 100pf; C0402
C39: 10pf; C0402
D1, D2, D3: PMEG4050EP,115; SODFL4725X110N
D4: 12V; LL-34
D5: 3V6; LL-34
F1: SMD1206R500SF; F1206
J1: M08SILK_FEMALE_PTH; 1X08
J2: M10SILK_FEMALE_PTH; 1X10
J3: M06SILK_FEMALE_PTH; 1X06
J4: M12PTH; 1X12
J5: FEMALE 2x3; 2X3
J6: 4P-SMD-2.0-90D; HW4-SMD-2.0-90D
J7: M04LONGPADS; 1X04_LONGPADS
K1: SKHM
K2: B3U-1000P; SW2-SMD-3.0X2.5X1.2+0.4MM
LED1: BLUE-0603; LED-0603
LED2: YELLOW-0603; LED-0603
Q1, Q2: MMBT3904LT1G; SOT23
Q3, Q4, Q5: DMG2305UX-7; SOT91P240X110-3N_DMG2305UX-7
R1, R2: 5.1K; R0402
R3, R4: 0R; R0402
R5: 24K; R0402
R6: 47K; R0402
R7, R8, R9, R10, R15, R16: 12K; R0402
R11, R12: 2.2K; R0402
R13, R14, R17: 100K; R0402
TP1, TP2, TP3, TP4, TP5, TP6: TPSQTP13SQ; TP13SQ
U1: ESP-WROOM-32; MODULE_ESP-WROOM-32
U2: CP2104-F03-GMR
U3, U4: V_REG_LM1117SOT223; SOT223
U5: ESDA6V1W5; SOT65P210X110-5N
USB1: 105450-0101
USB2: USB-B; USB-B-PTH
ZFC1, ZFC2, ZFC3: FIDUCIAL1X2; FIDUCIAL-1X2
ZFD1, ZFD2, ZFD3: FIDUCIAL1X2; FIDUCIAL-1X2
ZL1, ZL2: LAMLEOI_LOGO_3
ZL3: LAMLOEI_BIGLOGO

Connections:
3.3V: C4.2, C5.2, C6.2, C10.2, C11.2, C13.2, C16.2, C17.2, C29.2, C30.2, C33.2, C34.2, C35.+, C36.2, C37.2, C38.2, C39.2, D5.C (-), J4.5, J4.7, LED1.+, LED2.+, R7.1, R8.2, R13.2, R14.2, R15.2, U1.2 (3V3), U2.5 (VIO), U2.6 (VDD), U2.7 (REGIN), U3.2 (OUT), U3.4 (OUT)
5V: C9.2, C22.2, C27.2, C28.2, C31.2, D1.1 (K), F1.1, J2.8, J4.4, J5.2, J6.3, J7.2, Q3.2 (S), U5.4
DM: C3.2, R4.1, TP2.TP, U5.3, USB1.A7 (D1-), USB1.B7 (D2-), USB2.D-
DP: C2.2, R3.1, TP3.TP, U5.1, USB1.A6 (D1+), USB1.B6 (D2+), USB2.D+
DTR: Q2.2 (E), R9.1, U2.23 (DTR)
EN: C12.2, C14.2, J4.6, J5.5, K1.3 (S1), K1.4 (S2), Q1.3 (C), R15.1, U1.3 (EN)
GND: C1.1, C2.1, C3.1, C4.1, C5.1, C6.1, C7.1, C8.1, C9.1, C10.1, C11.1, C12.1, C13.1, C14.1, C15.1, C16.1, C17.1, C18.1, C19.1, C20.1, C21.1, C22.1, C23.1, C24.1, C25.1, C26.1, C27.1, C28.1, C29.1, C30.1, C31.1, C32.1, C33.1, C34.1, C35.-, C36.1, C37.1, C38.1, C39.1, D5.A (+), J2.7, J4.2, J4.3, J5.6, J6.4, J6.SS1, J6.SS2, J7.1, K1.1, K1.2, K2.1, R1.1, R2.1, R6.2, R11.1, R16.1, R17.1, TP4.TP, U1.1 (GND), U1.1.1 (GND), U1.1.2 (GND), U1.15 (GND), U1.38 (GND), U2.2 (GND), U2.25 (GND), U3.1 (ADJ), U4.1 (ADJ), U5.2, USB1.A1 (GND1), USB1.A12 (GND2), USB1.B1 (GND3), USB1.B12 (GND4), USB1.S1 (SHIELD), USB1.S2 (SHIELD), USB1.S3 (SHIELD), USB1.S4 (SHIELD), USB2.GND
IO0: C7.2, J4.8, J5.4, K2.2, Q2.3 (C), R8.1, U1.25 (IO0)
IO2: J1.3, R12.1, U1.24 (IO2)
IO4: J4.11, U1.26 (IO4)
IO5: J2.3, U1.29 (IO5)
IO12: J1.6, U1.14 (IO12)
IO13: J1.5, U1.16 (IO13)
IO14: J1.7, U1.13 (IO14)
IO15: J1.4, R16.2, U1.23 (IO15)
IO16: J1.1, U1.27 (IO16)
IO17: J1.2, U1.28 (IO17)
IO18: J2.6, U1.30 (IO18)
IO19: J2.5, U1.31 (IO19)
IO21: J2.9, J6.2, J7.3, R13.1, U1.33 (IO21)
IO22: J2.10, J6.1, J7.4, R14.1, U1.36 (IO22)
IO23: J2.4, U1.37 (IO23)
IO25: J3.2, U1.10 (IO25)
IO26: J3.1, U1.11 (IO26)
IO27: J1.8, U1.12 (IO27)
IO32: J2.2, U1.8 (IO32)
IO33: J2.1, U1.9 (IO33)
IO34: J3.4, U1.6 (IO34)
IO35: J3.3, U1.7 (IO35)
IO36: J3.6, U1.4 (SENSOR_VP)
IO39: J3.5, U1.5 (SENSOR_VN)
unnamed: R2.2, TP6.TP, USB1.B5 (CC2)
unnamed: R1.2, TP5.TP, USB1.A5 (CC1)
unnamed: R3.2, U2.3 (D+)
unnamed: R4.2, U2.4 (D-)
unnamed: R5.1, R6.1, U2.8 (VBUS)
unnamed: C15.2, C18.2, F1.2, U3.3 (IN)
unnamed: LED1.-, R11.2
unnamed: Q1.1 (B), R9.2
unnamed: Q2.1 (B), R10.2
unnamed: C23.2, C24.2, D3.1 (K), D4.C (-), Q5.2 (S), U4.3 (IN)
unnamed: R7.2, U2.9 (!RST)
unnamed: LED2.-, R12.2
unnamed: C8.2, U2.16 (VPP)
unnamed: D4.A (+), Q5.1 (G), R17.2
RTS: Q1.2 (E), R10.1, U2.19 (RTS)
RXD: J4.9, J5.3, U1.34 (RXD0), U2.21 (TXD)
TXD: J4.10, J5.1, U1.35 (TXD0), U2.20 (RXD)
VCCIO: C19.2, C20.2, C21.2, D1.2 (A), D2.2 (A), Q3.1 (G), Q4.1 (G), U4.2 (OUT), U4.4 (OUT)
VIN: C25.2, C26.2, C32.2, D2.1 (K), D3.2 (A), J4.1, Q4.2 (S), Q5.3 (D)
V_USB: C1.2, Q3.3 (D), Q4.3 (D), R5.2, TP1.TP, U5.5, USB1.A4 (VBUS1), USB1.A9 (VBUS2), USB1.B4 (VBUS3), USB1.B9 (VBUS4), USB2.VBUS

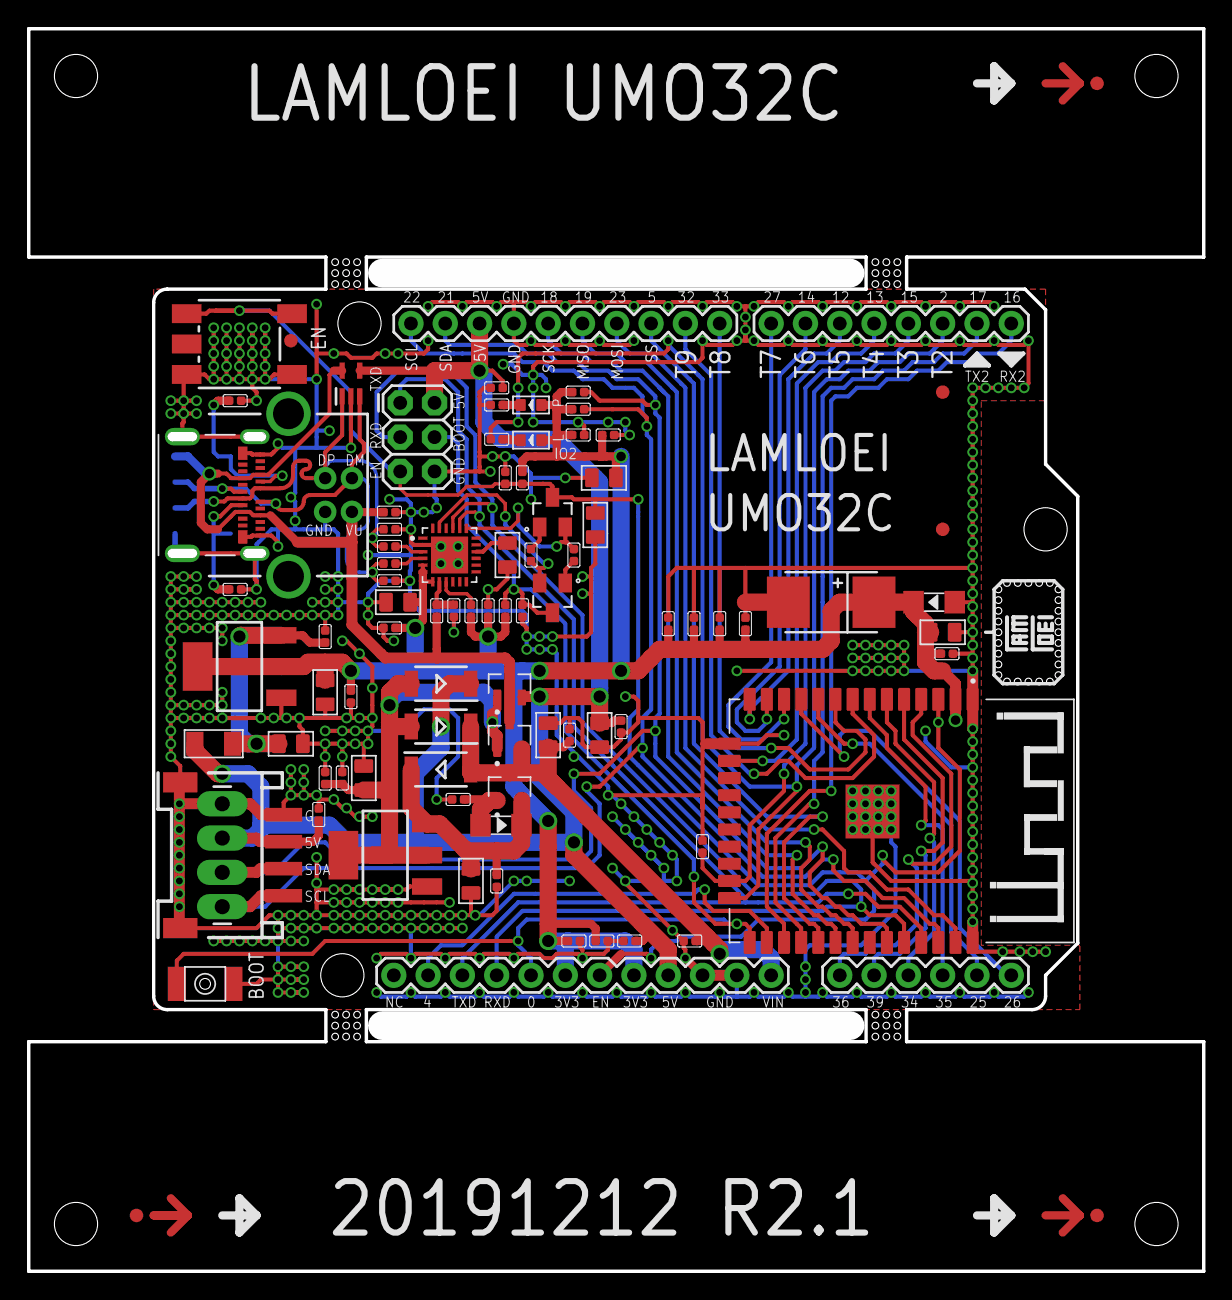
[picture p32: board lamloei_umo32c_r2_1.brd from above]

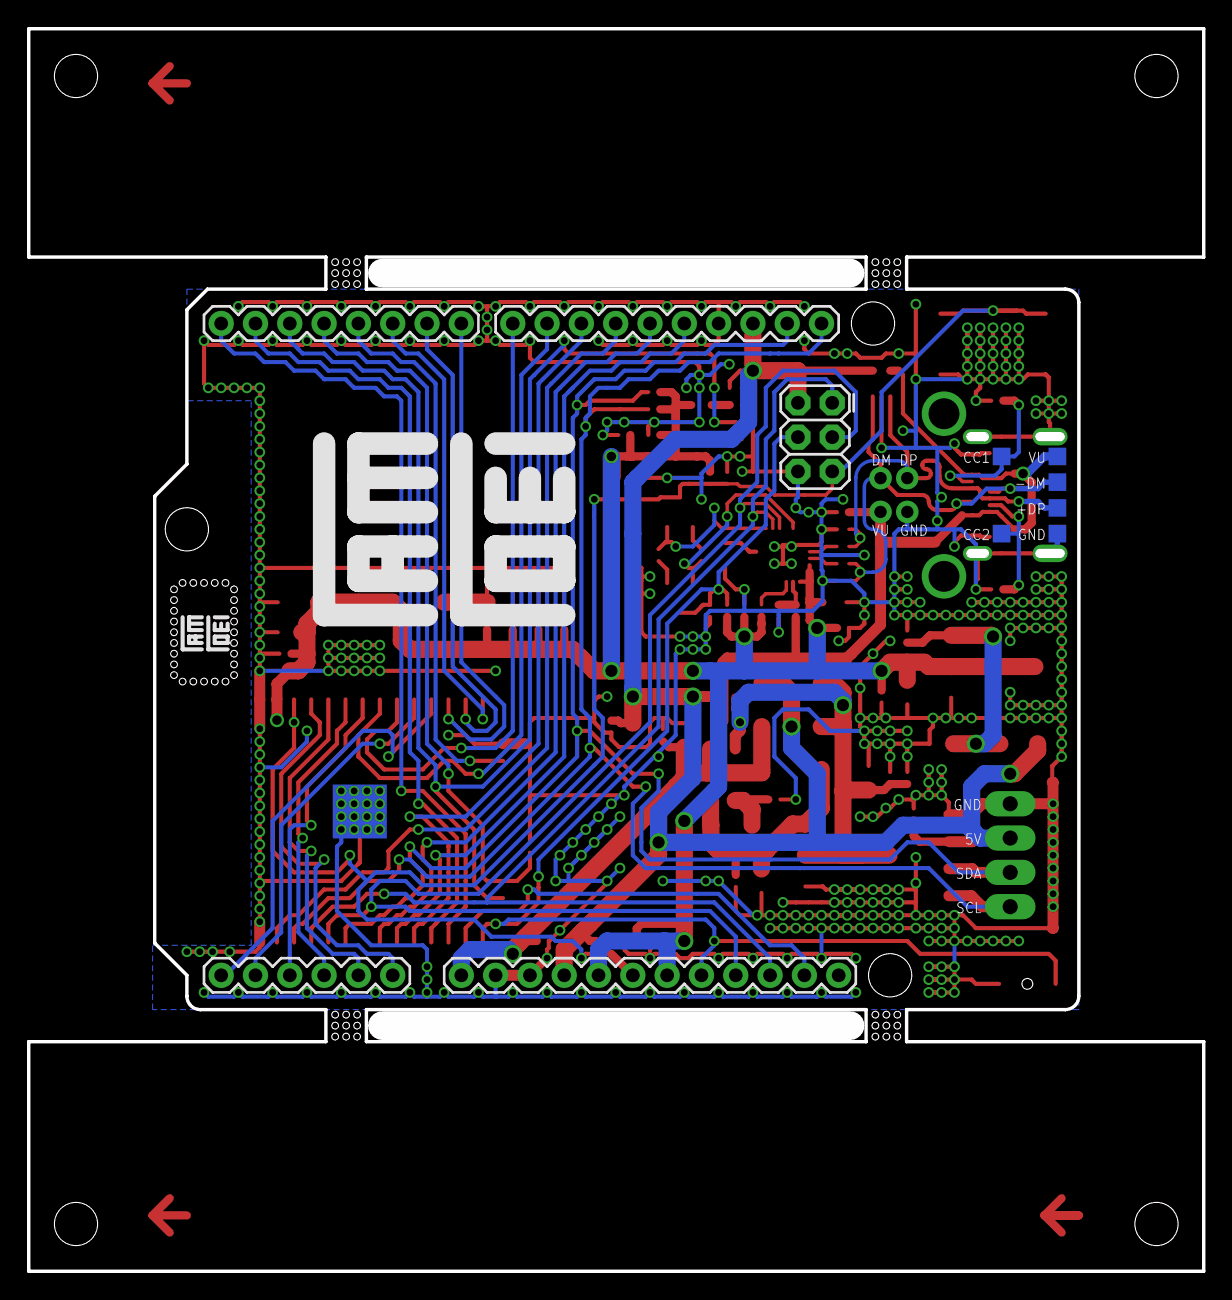
[picture p33: board lamloei_umo32c_r2_1.brd from below]

Board: 2 copper layers, 87.0 x 92.0 mm, 100 parts (8 on the bottom side), 51 nets.
