lamloei/LamLoei_Board/(notices)

Notices in the files:
parts and their libraries:
SparkFun-Connectors: Licensing: Creative Commons ShareAlike 4.0 International - https://creativecommons.org/licenses/by-sa/4.0
switch-alps: Copyright (C) 2009, Bob Starr
cap-pan40: Copyright (C) 2004, Bob Starr
